ntchris/voron_mod_super_diy/README.md

# voron_mod_super_diy
 all about my voron and ERCF mod
