ntchris/voron_mod_super_diy/Z_joints/notes.txt

cannot reduce height(thick) of Z joint lower, because magnet must point to sensor under xy joint 
unless both reduce 5mm
