ntchris/voron_mod_super_diy/ercf_v2/cnc_80T_pulley_mod/80T_pulley_size.jpg

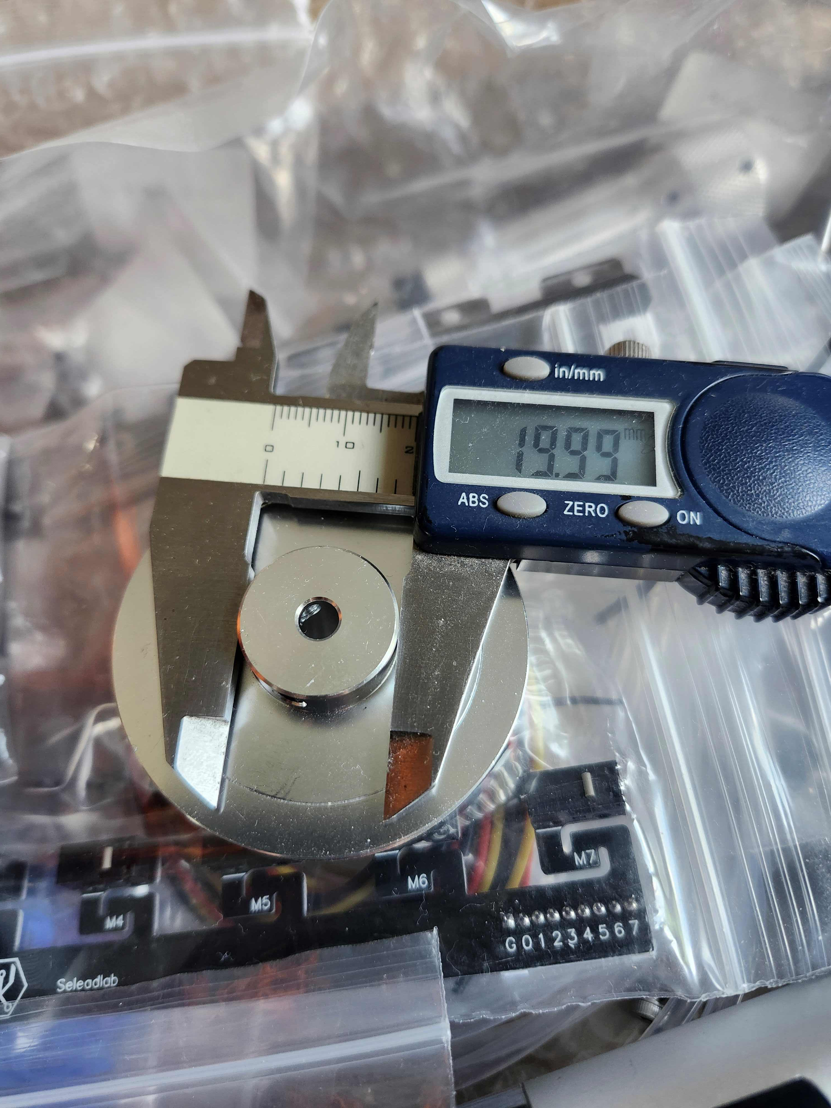
ercf_v2/cnc_80T_pulley_mod/80T_pulley_size.jpg
