ntchris/voron_mod_super_diy/ercf_v2/cnc_80T_pulley_mod/cad_picture1.png

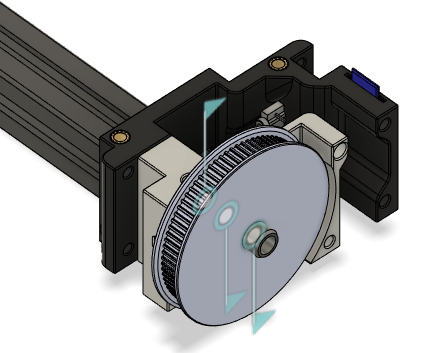
ercf_v2/cnc_80T_pulley_mod/cad_picture1.png
