ntchris/voron_mod_super_diy/ercf_v2/cnc_80T_pulley_mod/cad_picture3.png

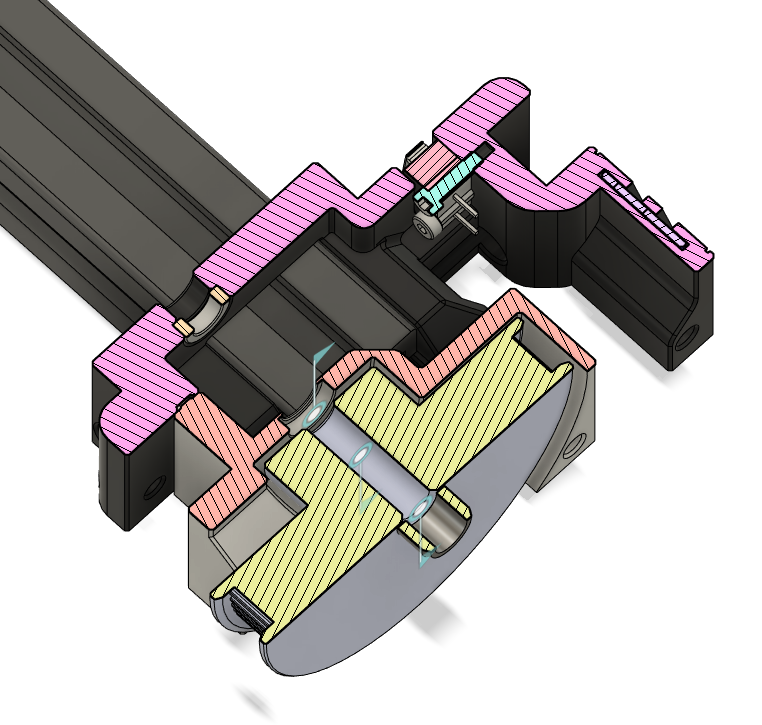
ercf_v2/cnc_80T_pulley_mod/cad_picture3.png
