ntchris/voron_mod_super_diy/ercf_v2/EREC_Cutter_Beta7_Mod/blade.jpg

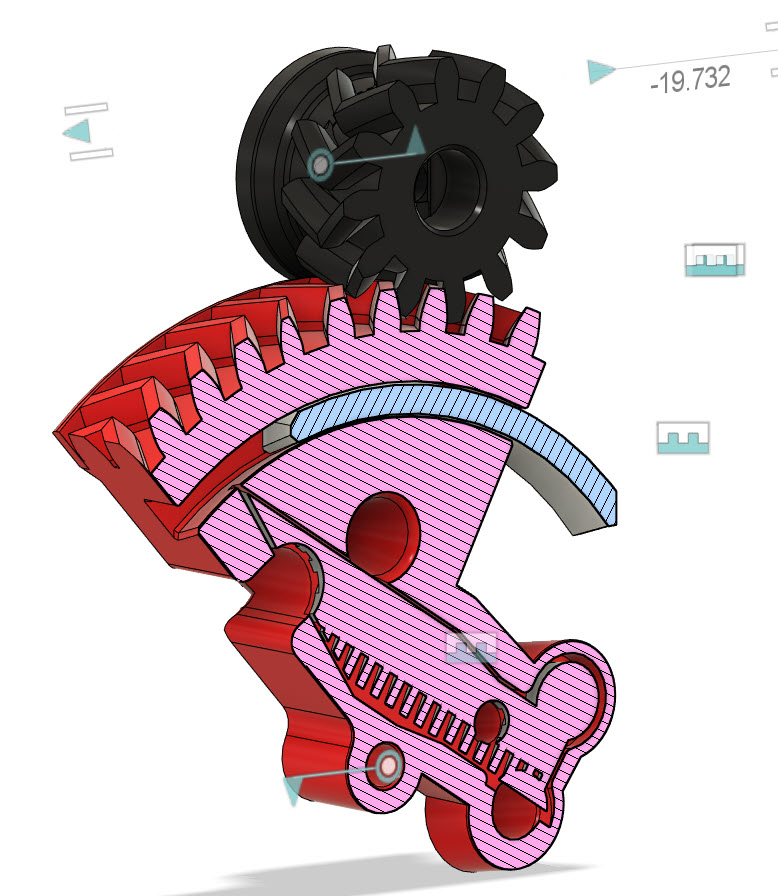
ercf_v2/EREC_Cutter_Beta7_Mod/blade.jpg
