ntchris/voron_mod_super_diy/ercf_v2/EREC_Cutter_Beta7_Mod/with_erec_cutter_beta7_mod.jpg

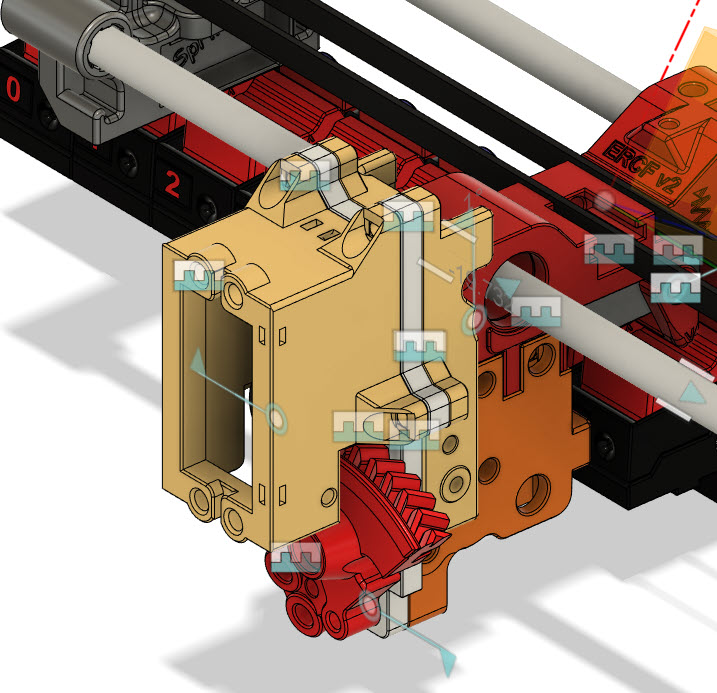
ercf_v2/EREC_Cutter_Beta7_Mod/with_erec_cutter_beta7_mod.jpg
