ntchris/voron_mod_super_diy/ercf_v2/etc/ercf_v2_middle_foot.jpg

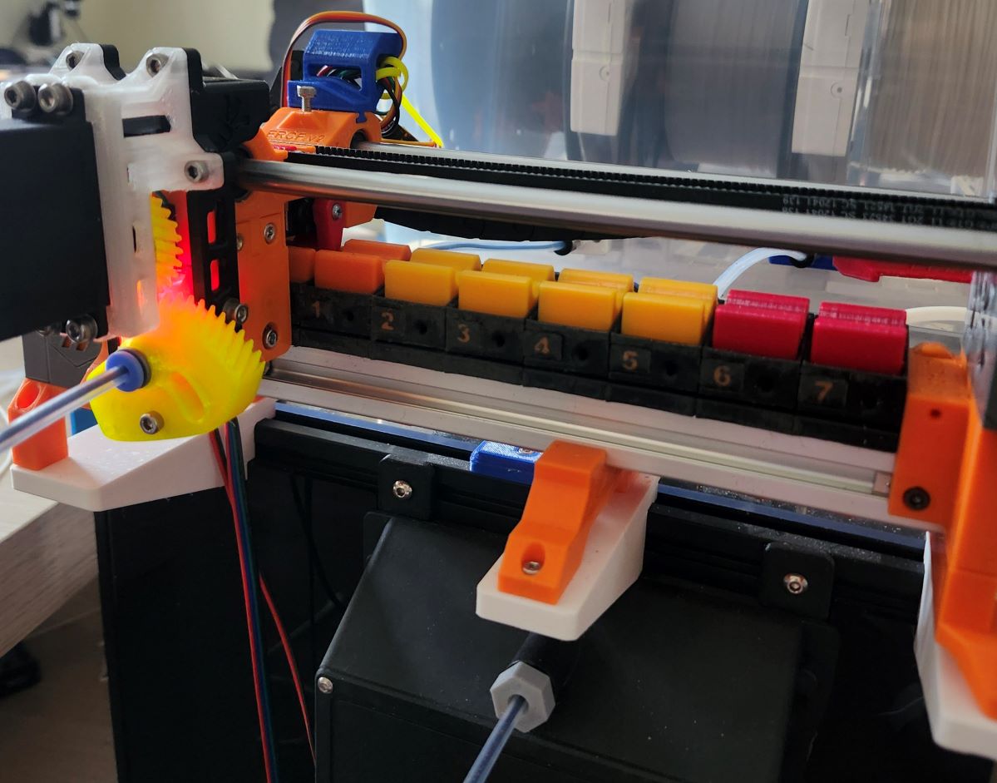
ercf_v2/etc/ercf_v2_middle_foot.jpg
