ntchris/voron_mod_super_diy/ercf_v2/filament_tension_sensor_hall/images/btt_mmb_stp.jpg

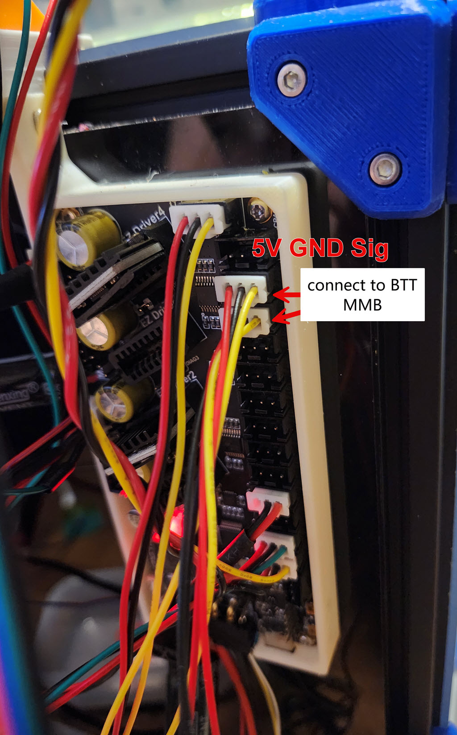
ercf_v2/filament_tension_sensor_hall/images/btt_mmb_stp.jpg
