ntchris/voron_mod_super_diy/ercf_v2/filament_tension_sensor_hall/images/image1.png

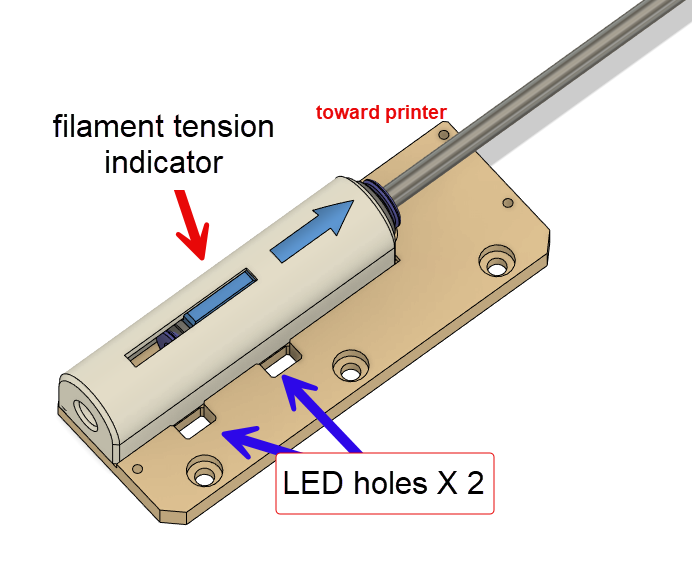
ercf_v2/filament_tension_sensor_hall/images/image1.png
