ntchris/voron_mod_super_diy/ercf_v2/filament_tension_sensor_hall/images/schematics.jpg

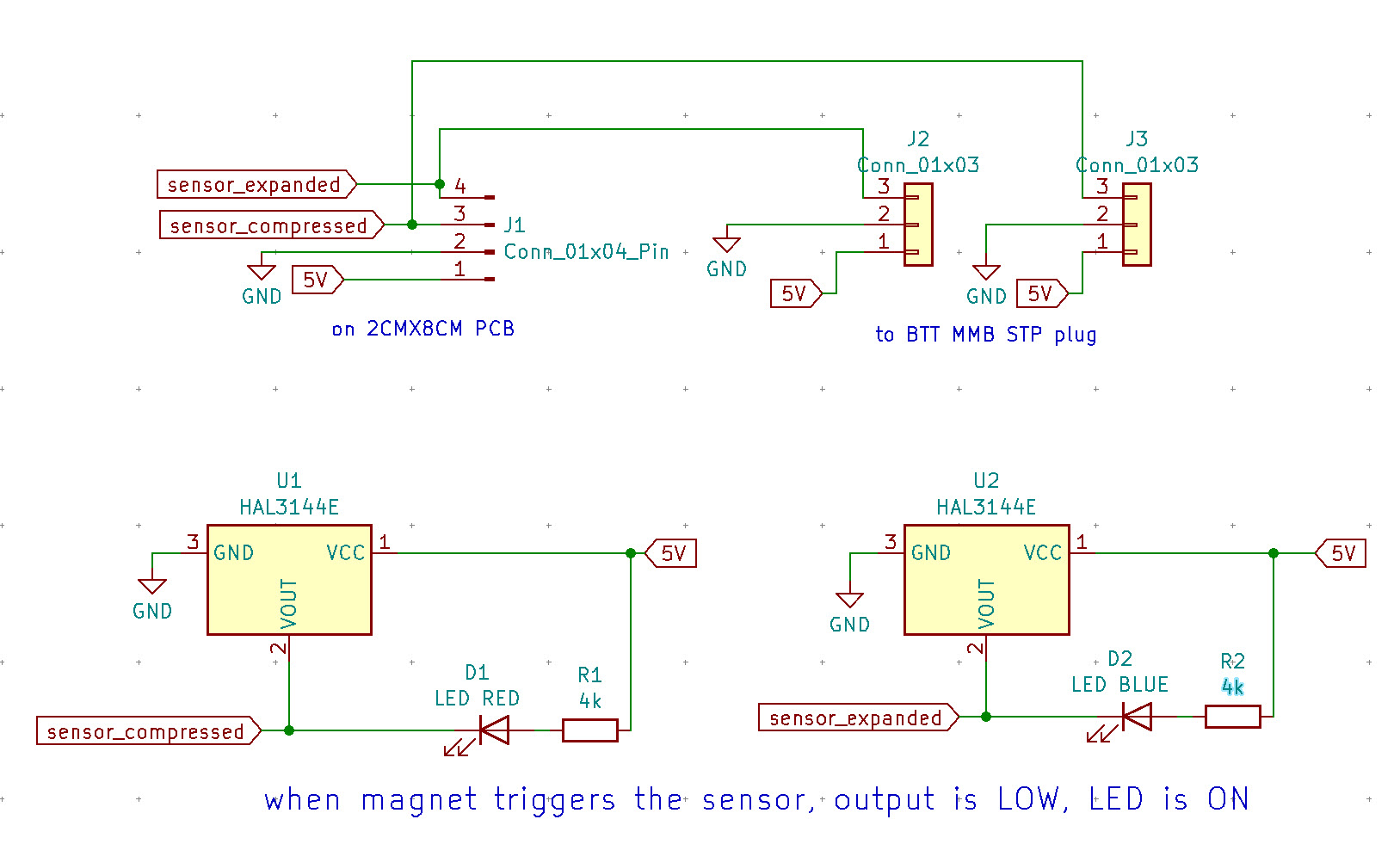
ercf_v2/filament_tension_sensor_hall/images/schematics.jpg
