ntchris/voron_mod_super_diy/ercf_v2/servo_28mm_selector_ver2/pictures/encoder_right_half.jpg

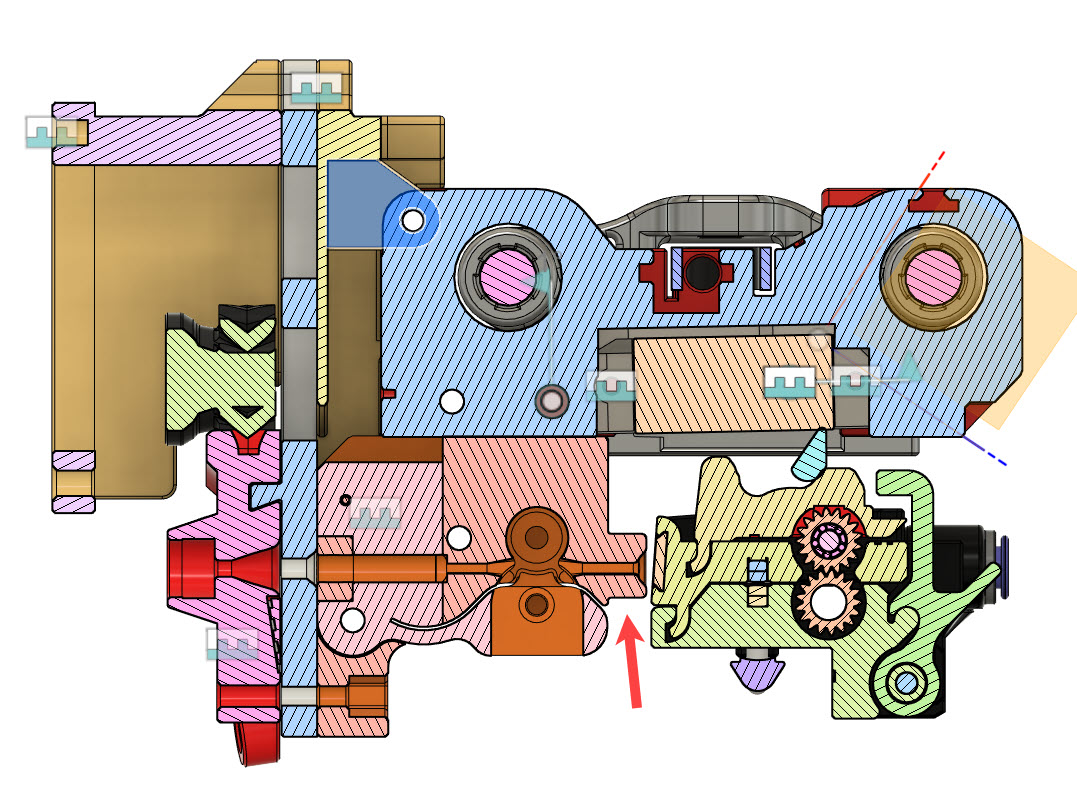
ercf_v2/servo_28mm_selector_ver2/pictures/encoder_right_half.jpg
