ntchris/voron_mod_super_diy/ercf_v2/servo_28mm_selector_ver2/pictures/servo28mm.jpg

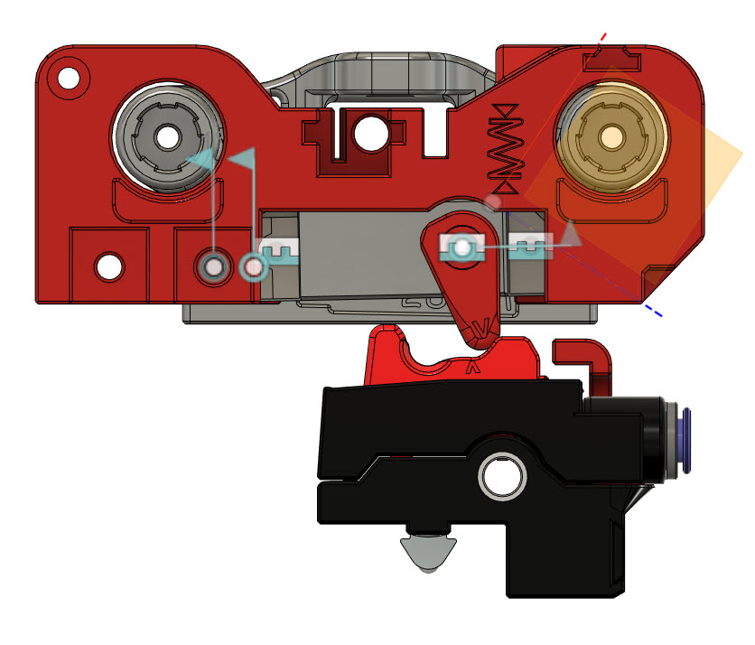
ercf_v2/servo_28mm_selector_ver2/pictures/servo28mm.jpg
