ntchris/voron_mod_super_diy/for_enraged_rabbit/about_servo/Guo_Hua_9g_A0090.jpg

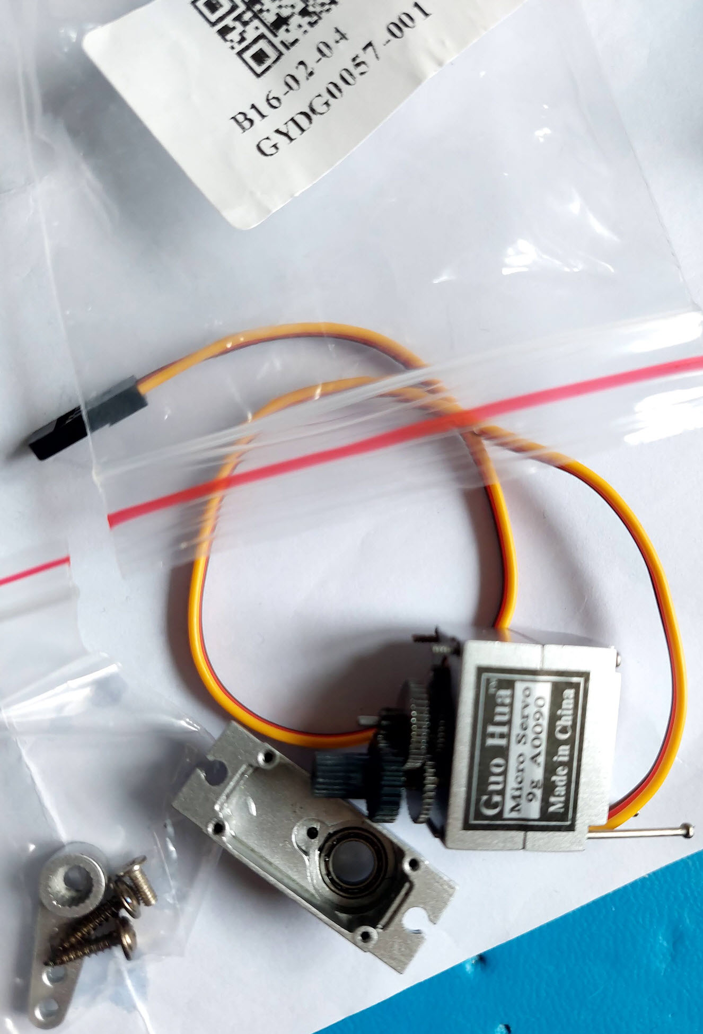
for_enraged_rabbit/about_servo/Guo_Hua_9g_A0090.jpg
