ntchris/voron_mod_super_diy/for_enraged_rabbit/about_servo/surpass_17g.jpg

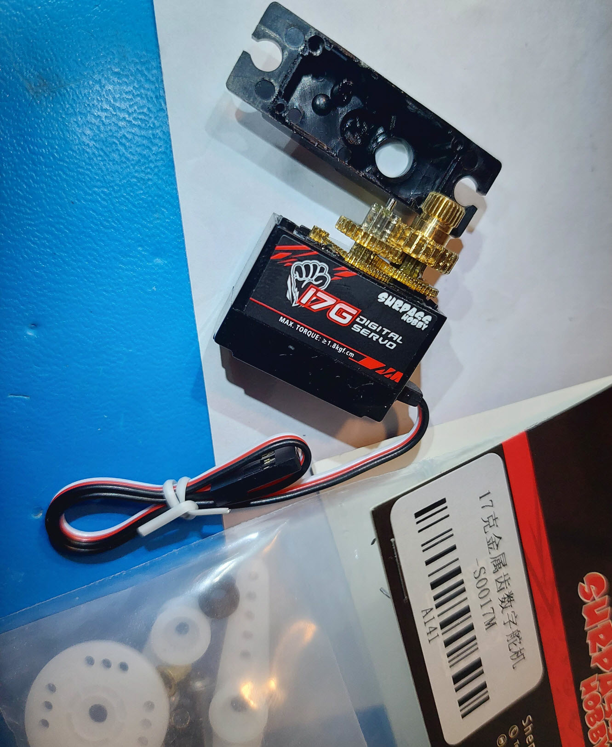
for_enraged_rabbit/about_servo/surpass_17g.jpg
