ntchris/voron_mod_super_diy/for_enraged_rabbit/mellow_ERCF_CanBus/mellow_ercf_jumper.jpg

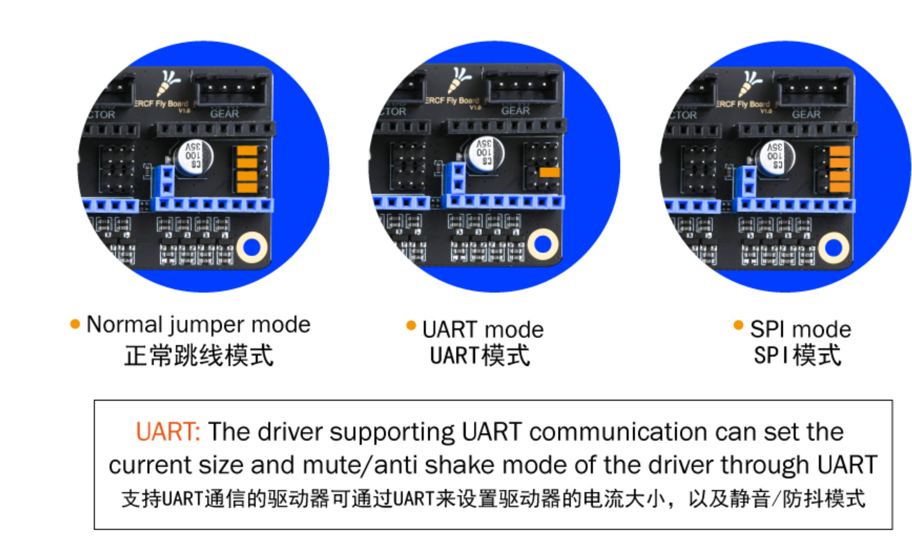
for_enraged_rabbit/mellow_ERCF_CanBus/mellow_ercf_jumper.jpg
