ntchris/voron_mod_super_diy/for_enraged_rabbit/mount_on_voron/ercf_mount2.jpg

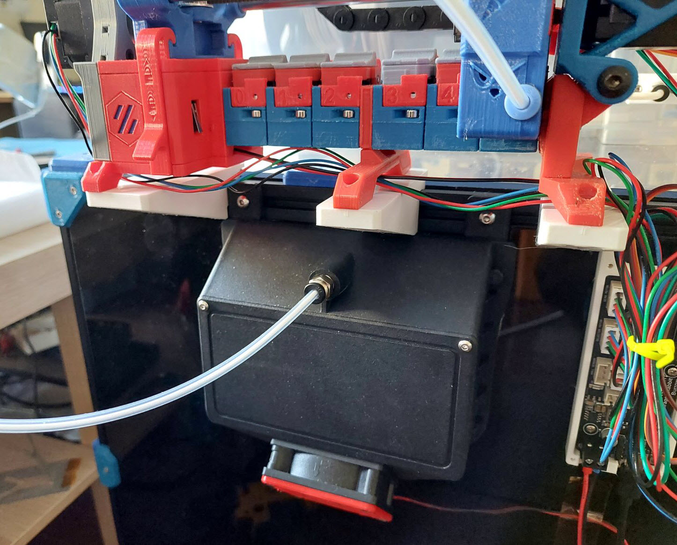
for_enraged_rabbit/mount_on_voron/ercf_mount2.jpg
