ntchris/voron_mod_super_diy/for_enraged_rabbit/optical_endstop_selector/optical_endstop_inside.jpg

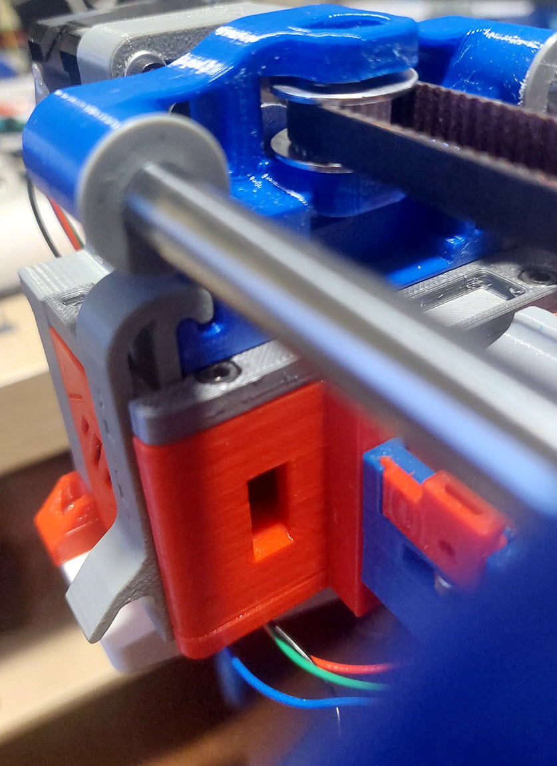
for_enraged_rabbit/optical_endstop_selector/optical_endstop_inside.jpg
