ntchris/voron_mod_super_diy/for_enraged_rabbit/optical_endstop_selector_button/show1.jpg

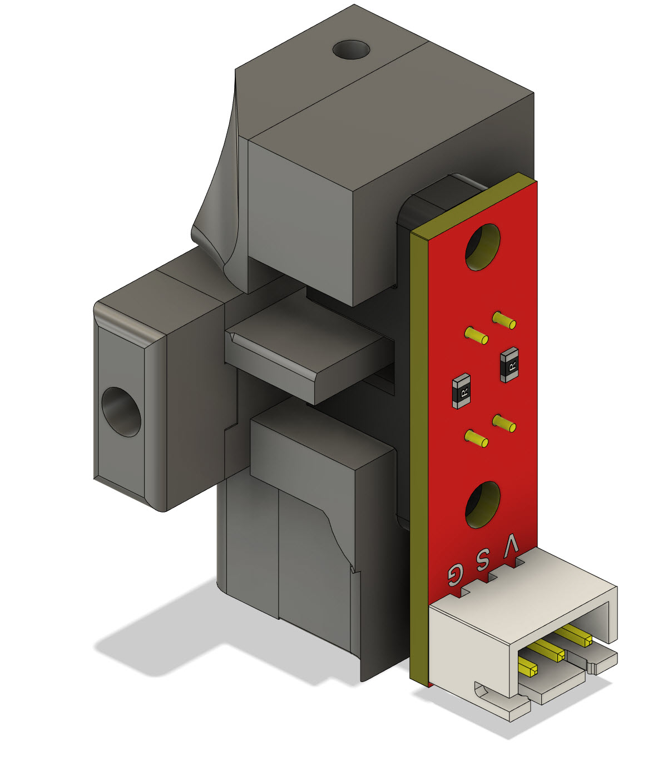
for_enraged_rabbit/optical_endstop_selector_button/show1.jpg
