ntchris/voron_mod_super_diy/for_enraged_rabbit/optical_endstop_selector_button/show2.jpg

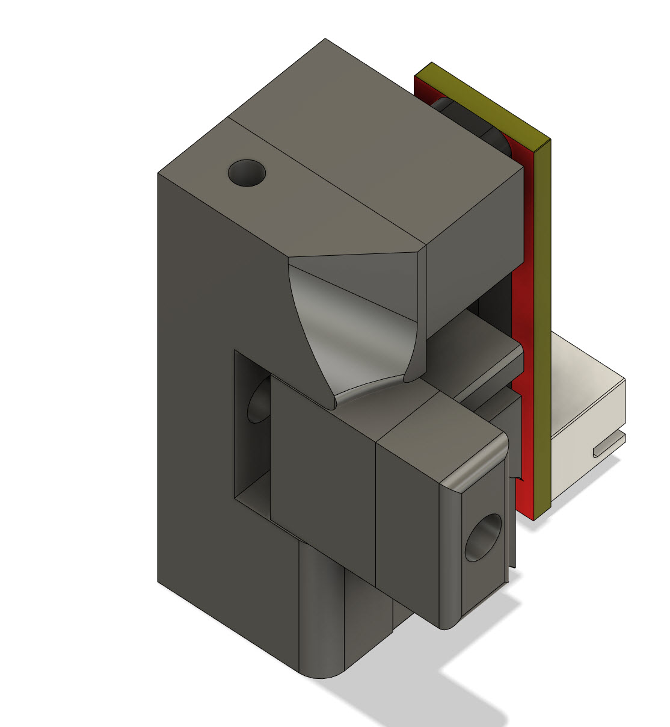
for_enraged_rabbit/optical_endstop_selector_button/show2.jpg
