ntchris/voron_mod_super_diy/stealth_burner_rail_mount/voron_stealburn_x_belt_show.jpg

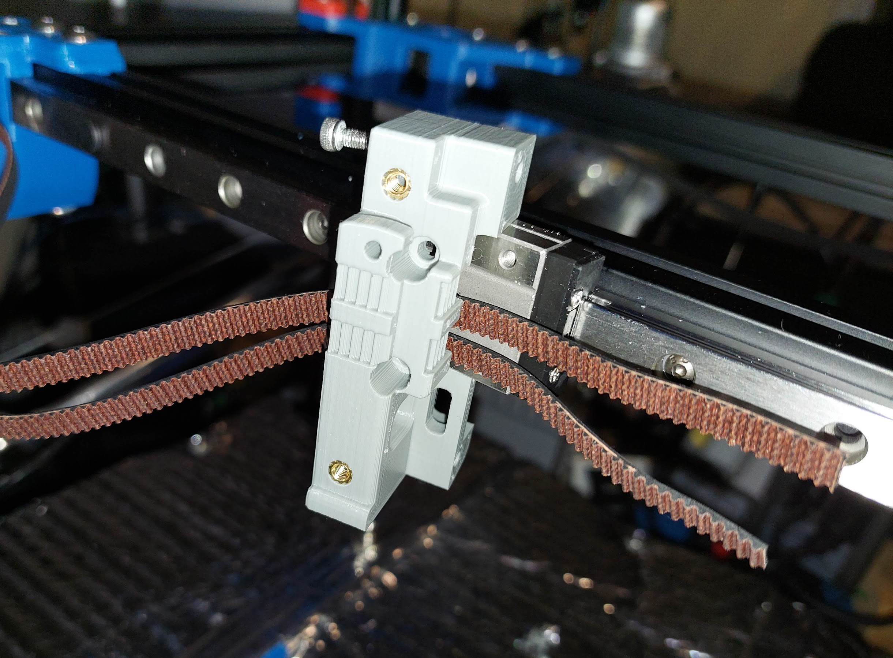
stealth_burner_rail_mount/voron_stealburn_x_belt_show.jpg
