ntchris/voron_mod_super_diy/super_diy_motor_buffer_mmu_samla/doc/magnet_1.jpg

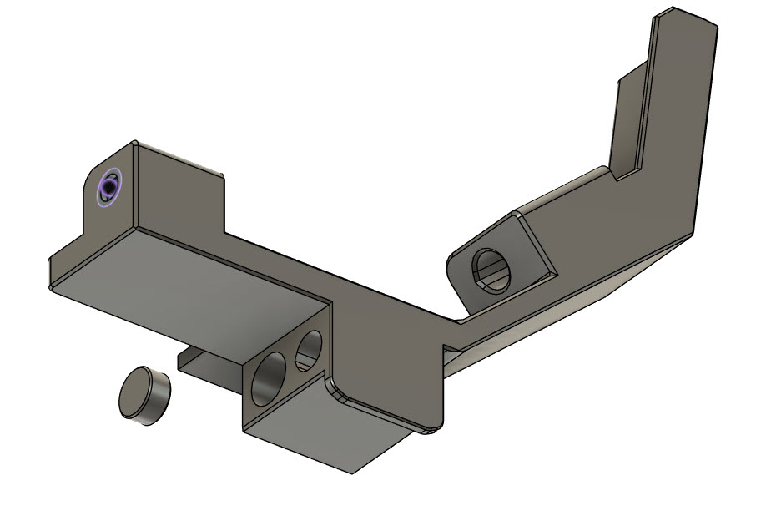
super_diy_motor_buffer_mmu_samla/doc/magnet_1.jpg
