ntchris/voron_mod_super_diy/super_diy_motor_buffer_mmu_samla/doc/main_base_heat_insert.jpg

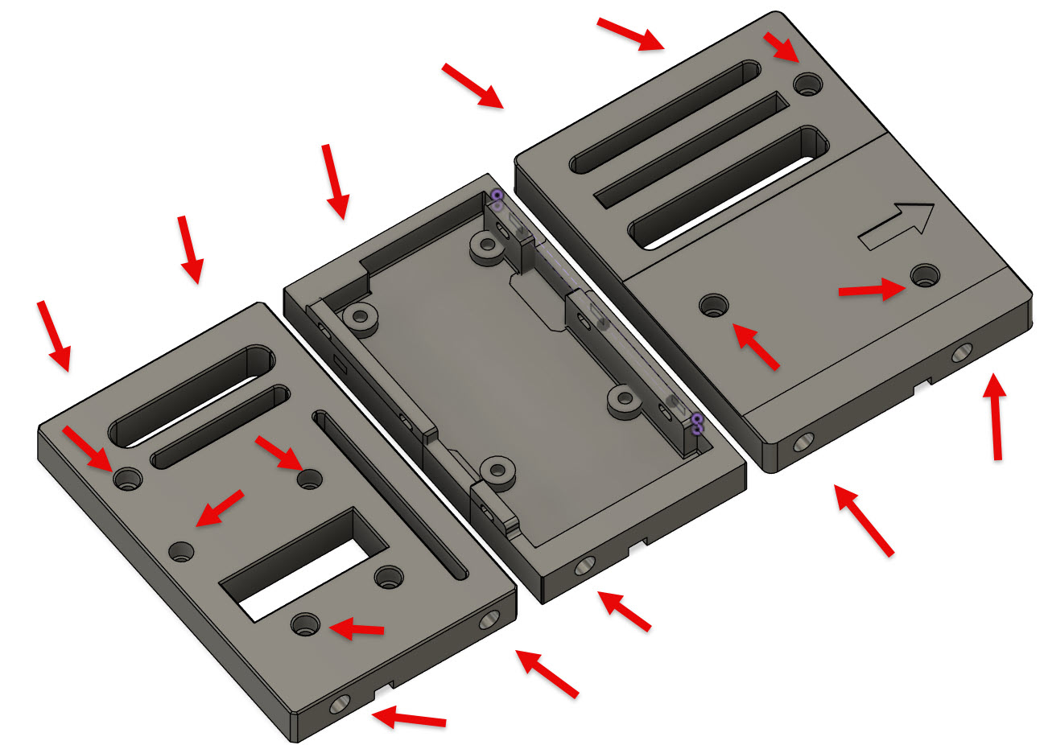
super_diy_motor_buffer_mmu_samla/doc/main_base_heat_insert.jpg
