ntchris/voron_mod_super_diy/super_diy_motor_buffer_mmu_samla/doc/push_pull_sensor.jpg

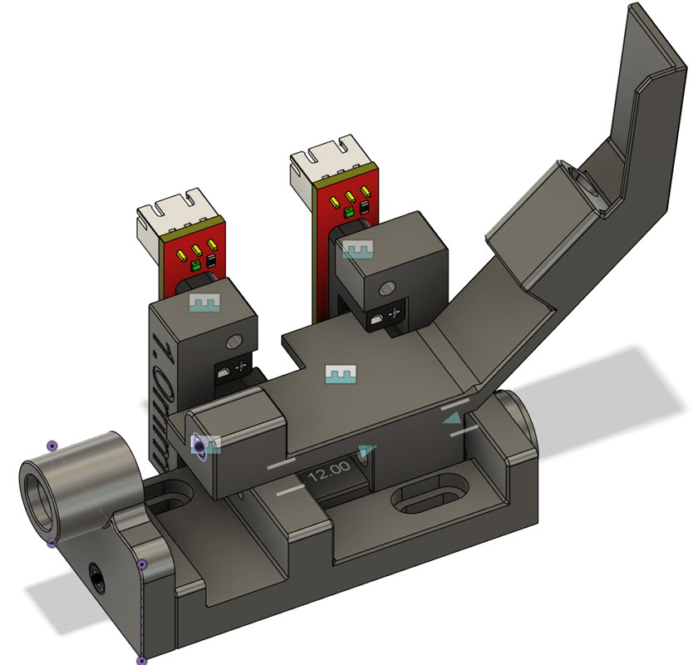
super_diy_motor_buffer_mmu_samla/doc/push_pull_sensor.jpg
