ntchris/voron_mod_super_diy/super_diy_motor_buffer_mmu_samla/doc/sensor_module_on_base.jpg

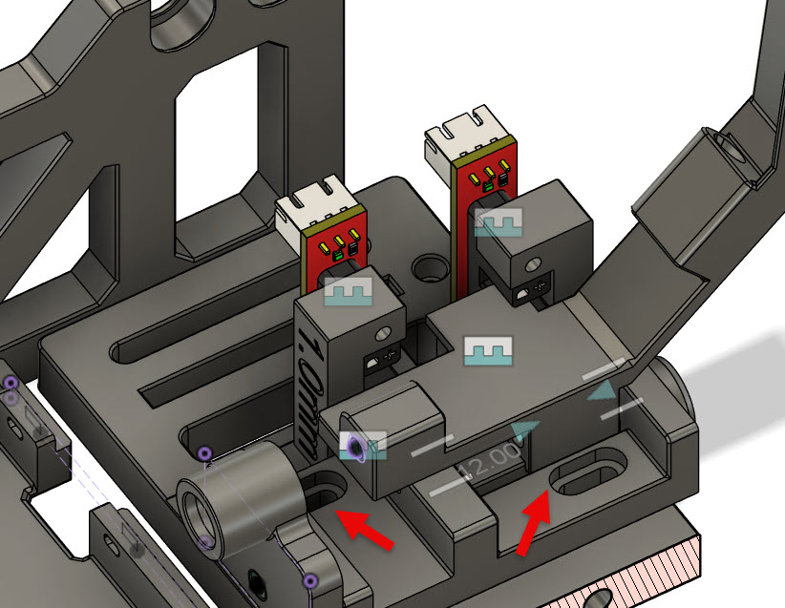
super_diy_motor_buffer_mmu_samla/doc/sensor_module_on_base.jpg
