ntchris/voron_mod_super_diy/super_diy_motor_buffer_mmu_samla/software/Pinout-Arduino-Nano-low-resolution.jpg

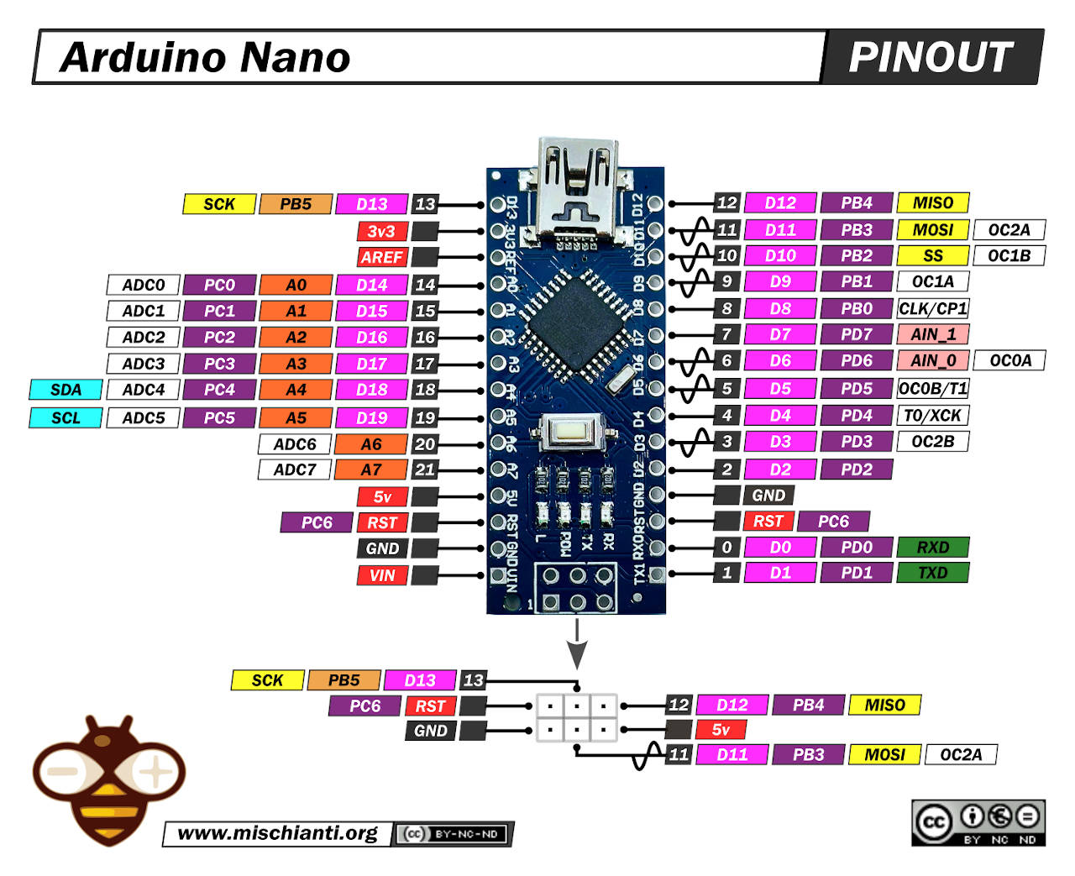
super_diy_motor_buffer_mmu_samla/software/Pinout-Arduino-Nano-low-resolution.jpg
