ntchris/voron_mod_super_diy/XY_Joints/M5_xy_joint_weight.jpg

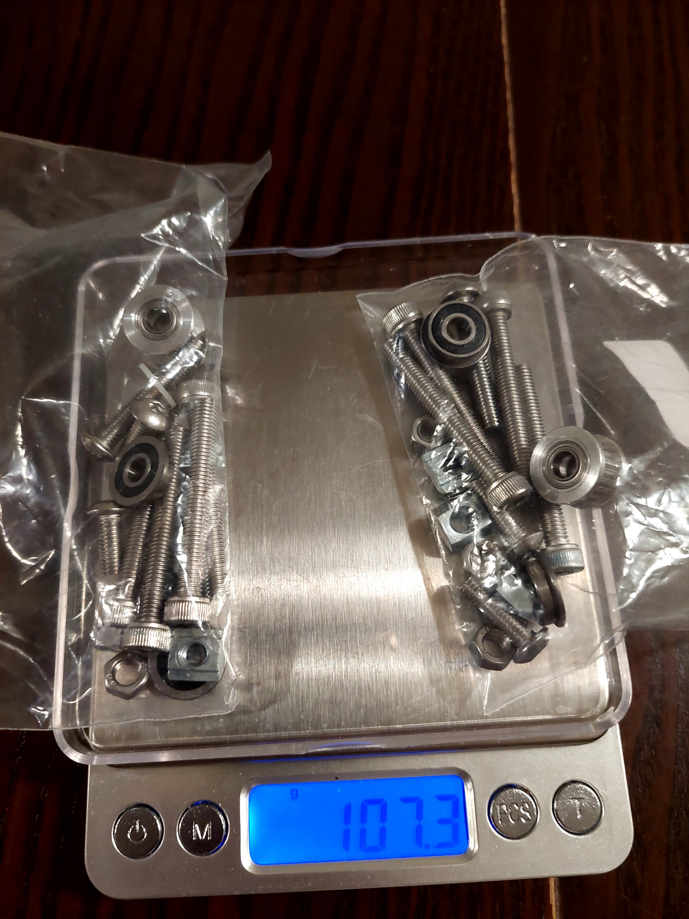
XY_Joints/M5_xy_joint_weight.jpg
