ntchris/voron_mod_super_diy/Z_Idlers_mods/z_idler_bracket_M4.jpg

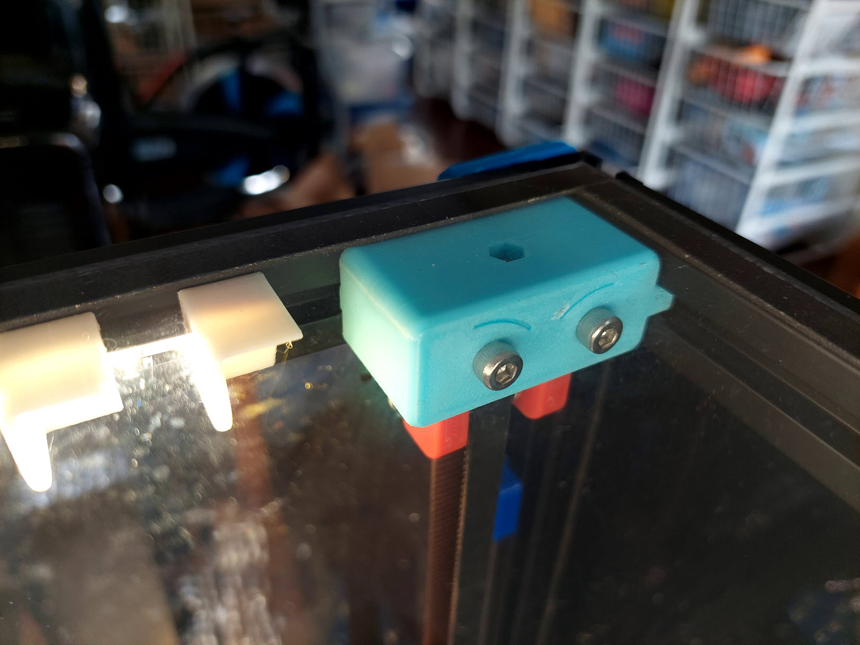
Z_Idlers_mods/z_idler_bracket_M4.jpg
