ntchris/voron_mod_super_diy/ercf_v2/EREC_Cutter_Beta7_Mod/CAD/ercf_cutter_beta7_adaptor.step

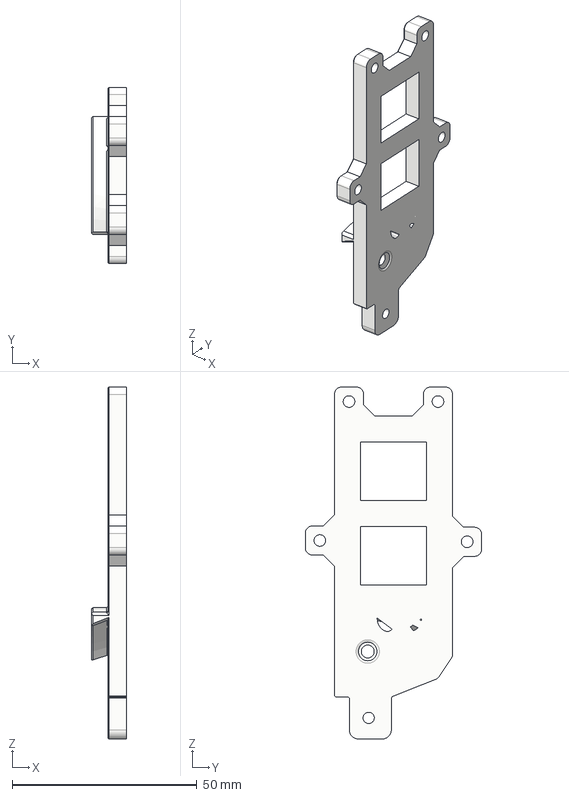
[picture p76: CAD file, 2024-09-14]
ercf_v2/EREC_Cutter_Beta7_Mod/CAD/ercf_cutter_beta7_adaptor.step
9.35 x 47.8 x 95.3 mm
