ntchris/voron_mod_super_diy/ercf_v2/etc/drag_chain_body.stl

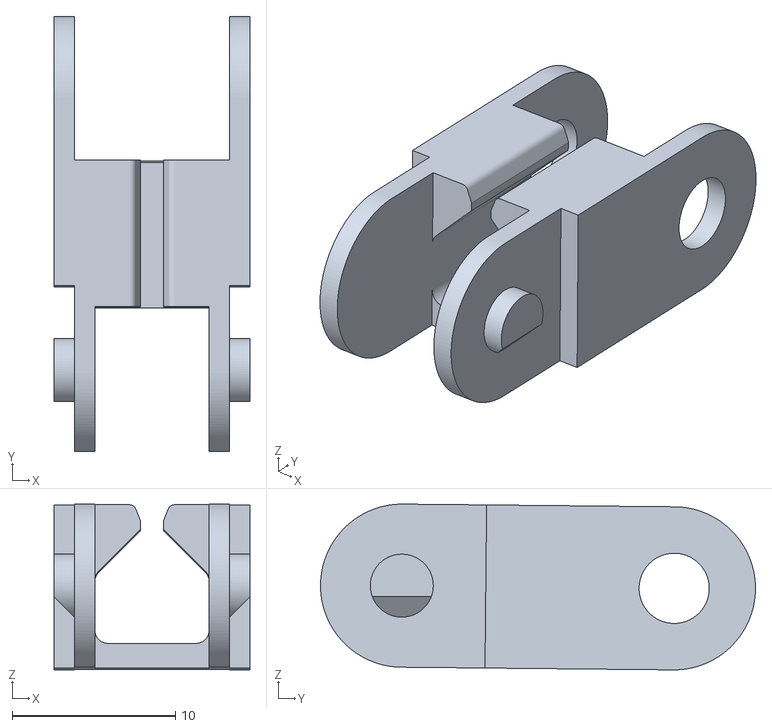
[picture p77: CAD file, 2024-08-27]
ercf_v2/etc/drag_chain_body.stl
12.0 x 26.7 x 10.2
