ntchris/voron_mod_super_diy/ercf_v2/filament_tension_sensor_hall/CAD/mover.step

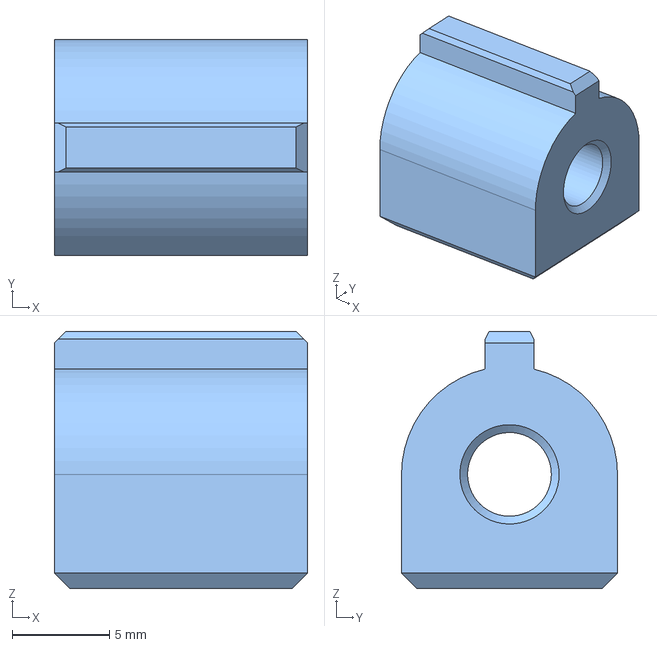
[picture p78: CAD file, 2024-08-27]
ercf_v2/filament_tension_sensor_hall/CAD/mover.step
13.0 x 11.1 x 13.2 mm
