ntchris/voron_mod_super_diy/ercf_v2/filament_tension_sensor_hall/stl/sign.stl

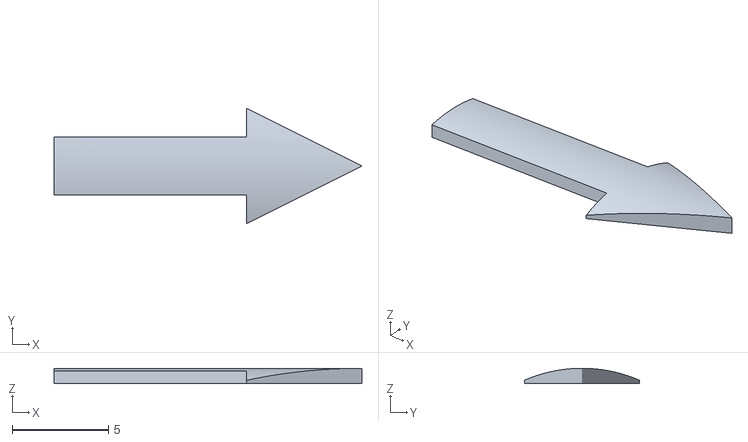
[picture p79: CAD file, 2024-08-27]
ercf_v2/filament_tension_sensor_hall/stl/sign.stl
16.0 x 6.00 x 0.8
