ntchris/voron_mod_super_diy/ercf_v2/power_drive_selector_60T_pulley/CAD/pulley_mount_default_M5.step

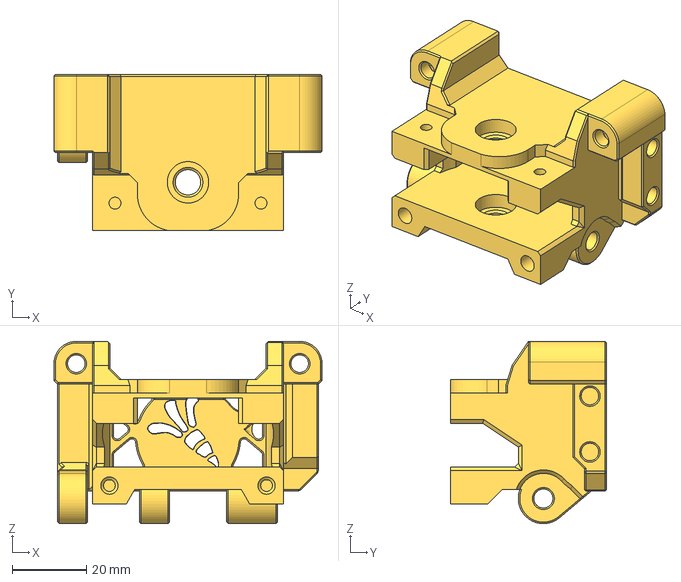
[picture p80: CAD file, 2024-09-14]
ercf_v2/power_drive_selector_60T_pulley/CAD/pulley_mount_default_M5.step
72.0 x 42.0 x 48.9 mm
