ntchris/voron_mod_super_diy/ercf_v2/servo_28mm_selector_ver2/CAD/servo_arm_6mm_25T.step

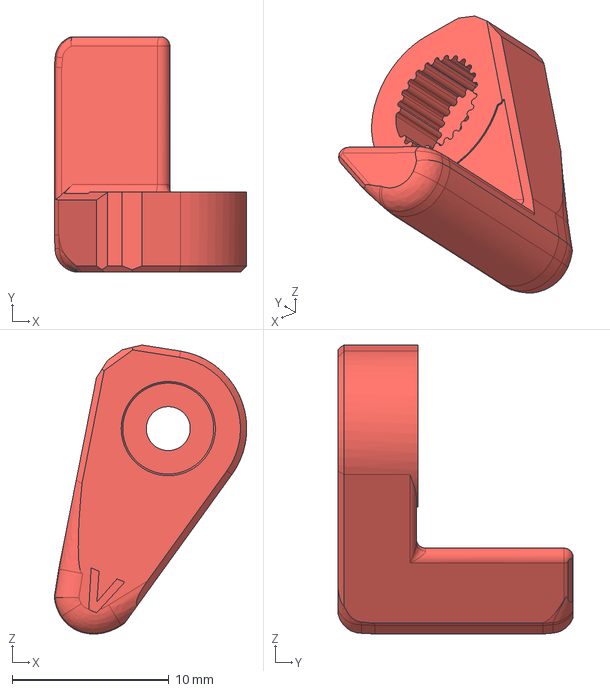
[picture p81: CAD file, 2024-09-14]
ercf_v2/servo_28mm_selector_ver2/CAD/servo_arm_6mm_25T.step
12.3 x 15.0 x 18.4 mm
