ntchris/voron_mod_super_diy/Exhaust_Filter/[a]_exhaust_filter_mount_M3_x2.step

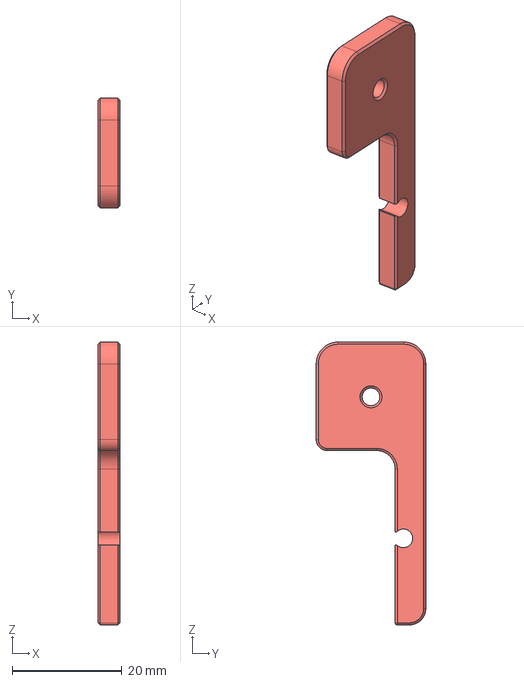
[picture p82: CAD file, 2023-09-17]
Exhaust_Filter/[a]_exhaust_filter_mount_M3_x2.step
4.00 x 20.0 x 51.6 mm
