ntchris/voron_mod_super_diy/for_enraged_rabbit/easy_optical/cad_stl/easy_optical_pcb.step

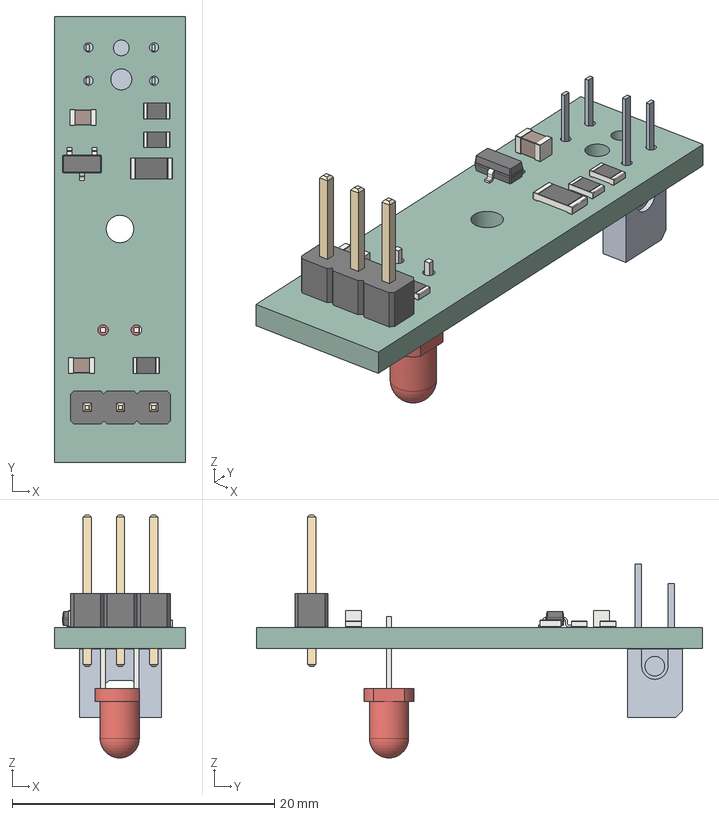
[picture p83: CAD file, 2023-10-31]
for_enraged_rabbit/easy_optical/cad_stl/easy_optical_pcb.step
10.0 x 34.0 x 18.5 mm
_autosave-easy_optical_pcb PCB
