ntchris/voron_mod_super_diy/for_enraged_rabbit/mount_on_voron/ercf_pcb_mount_side_mellow_canbus.stl

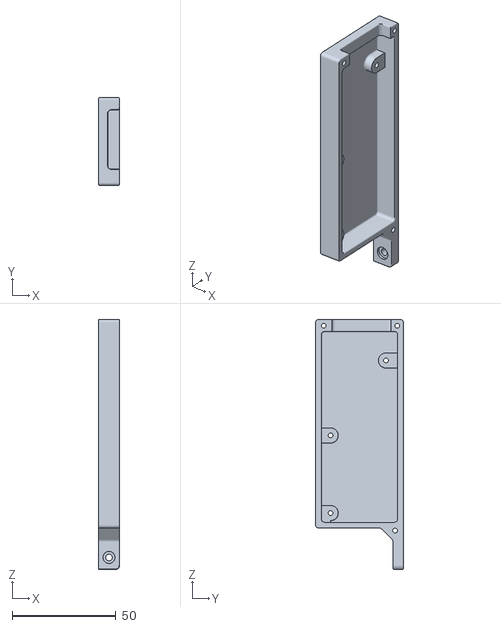
[picture p84: CAD file, 2023-10-22]
for_enraged_rabbit/mount_on_voron/ercf_pcb_mount_side_mellow_canbus.stl
10.2 x 42.4 x 120.6
