ntchris/voron_mod_super_diy/for_enraged_rabbit/optical_endstop_selector/ercf_top_panel_optical.stl

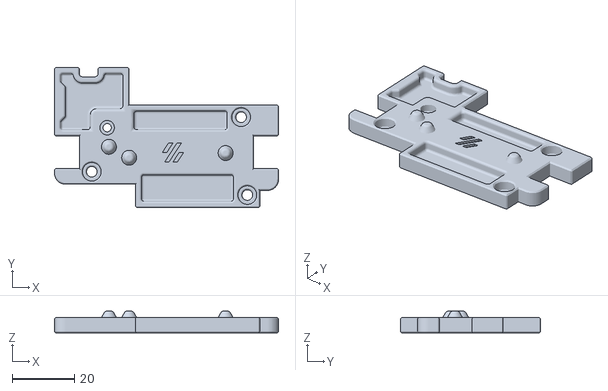
[picture p85: CAD file, 2023-10-22]
for_enraged_rabbit/optical_endstop_selector/ercf_top_panel_optical.stl
72.0 x 45.0 x 7.00
