ntchris/voron_mod_super_diy/for_enraged_rabbit/optical_endstop_selector_button/pin_button_front.stl

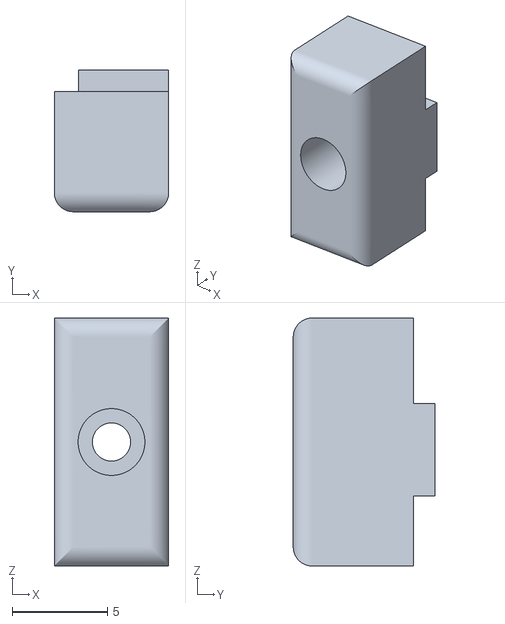
[picture p86: CAD file, 2023-10-22]
for_enraged_rabbit/optical_endstop_selector_button/pin_button_front.stl
6.00 x 7.42 x 13.0
