ntchris/voron_mod_super_diy/stealth_burner_rail_mount/x_carriage_frame_left_belt_wrap.step

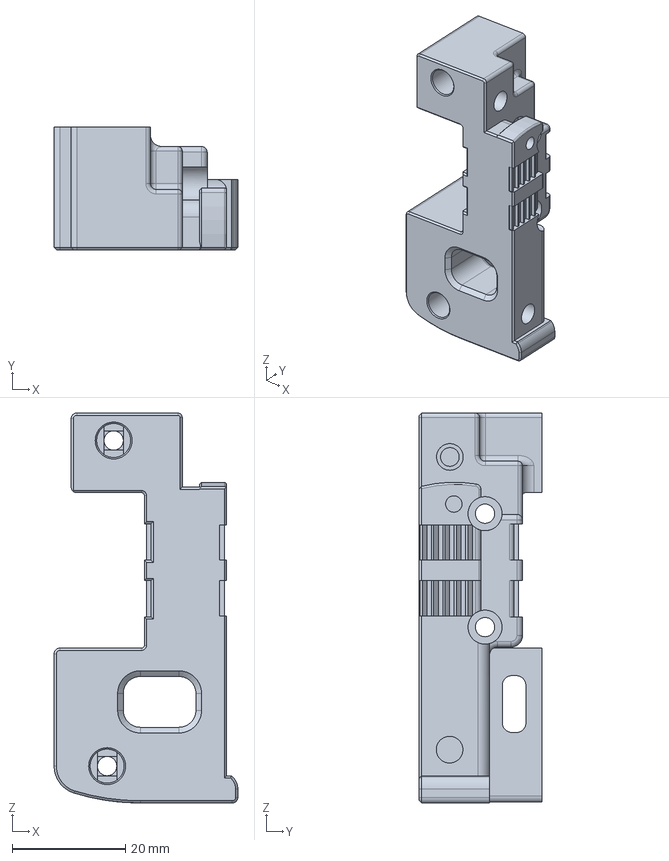
[picture p87: CAD file, 2023-09-17]
stealth_burner_rail_mount/x_carriage_frame_left_belt_wrap.step
32.4 x 21.6 x 68.8 mm
