ntchris/voron_mod_super_diy/XY_Joints/xy_joint_left_upper_M4.step

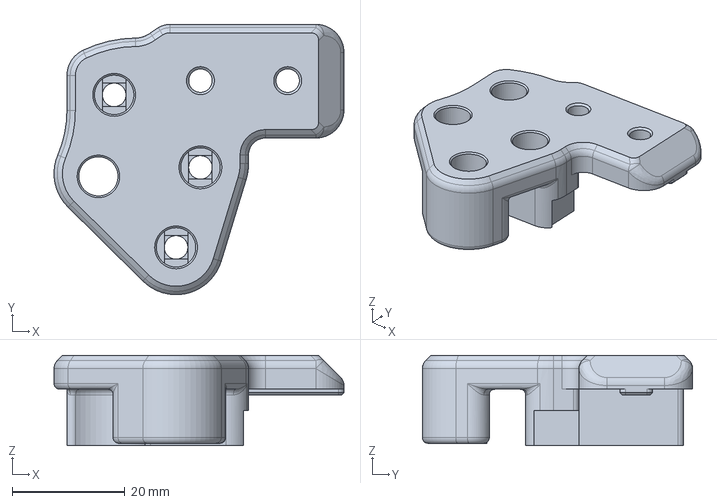
[picture p88: CAD file, 2023-09-17]
XY_Joints/xy_joint_left_upper_M4.step
51.5 x 48.0 x 16.0 mm
