ntchris/voron_mod_super_diy/Z_Idlers_mods/z_tensioner_bracket_M4_b_x2.step

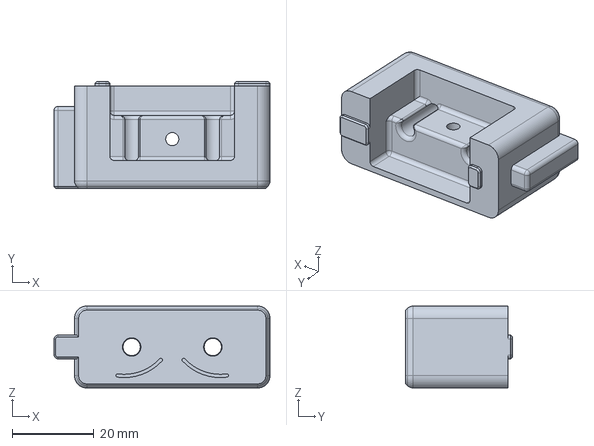
[picture p89: CAD file, 2023-09-17]
Z_Idlers_mods/z_tensioner_bracket_M4_b_x2.step
52.7 x 26.0 x 20.0 mm
