ntchris/voron_mod_super_diy/ercf_v2/EREC_Cutter_Beta7_Mod/CAD/Cutter_Arm_ECAS_Open.step

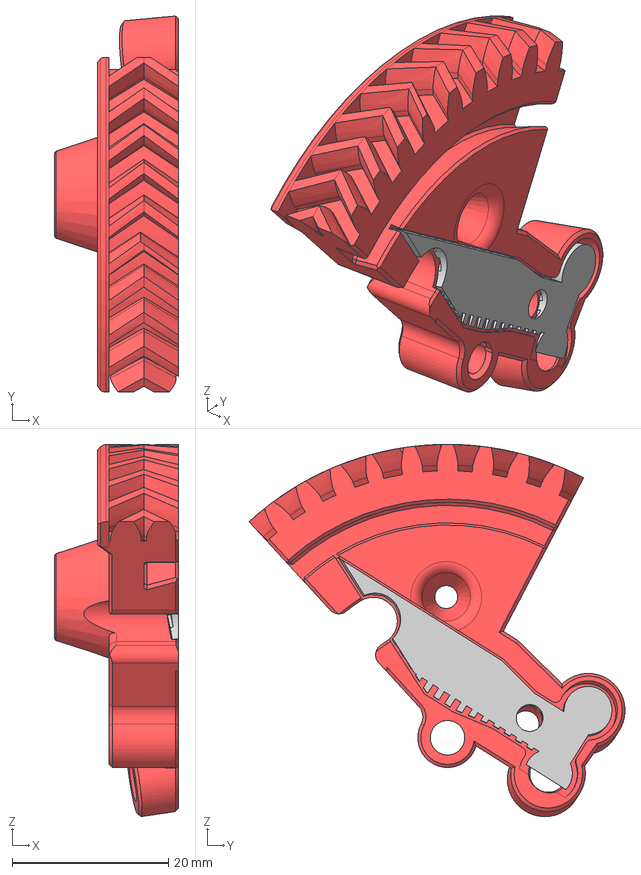
[picture p90: CAD file, 2024-09-14]
ercf_v2/EREC_Cutter_Beta7_Mod/CAD/Cutter_Arm_ECAS_Open.step
15.9 x 48.1 x 47.6 mm
