ntchris/voron_mod_super_diy/ercf_v2/etc/erec_encoder_mount_for_thicker_selector_28mm.stl

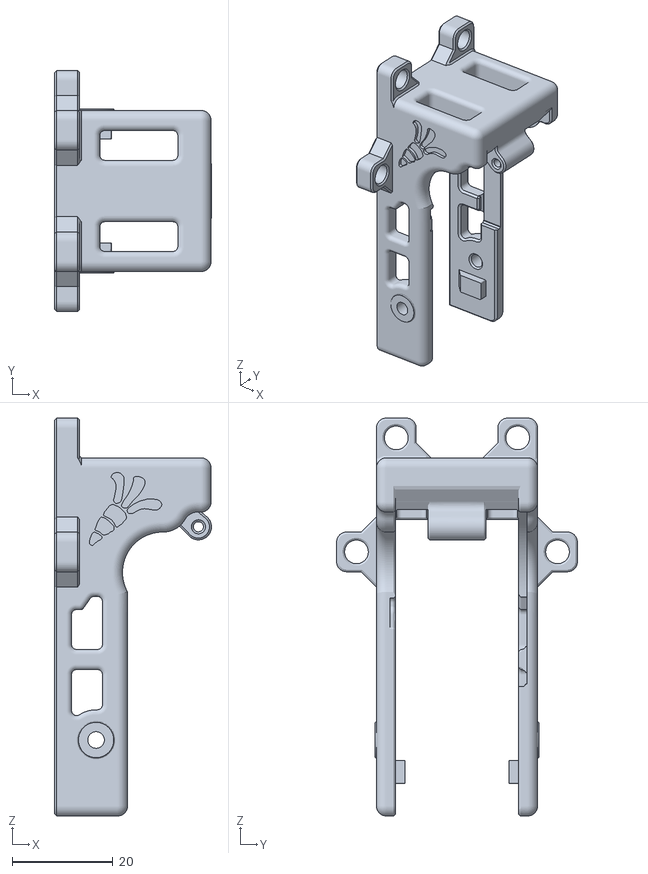
[picture p91: CAD file, 2024-08-11]
ercf_v2/etc/erec_encoder_mount_for_thicker_selector_28mm.stl
31.2 x 47.8 x 79.0
