ntchris/voron_mod_super_diy/ercf_v2/filament_tension_sensor_hall/CAD/case.step

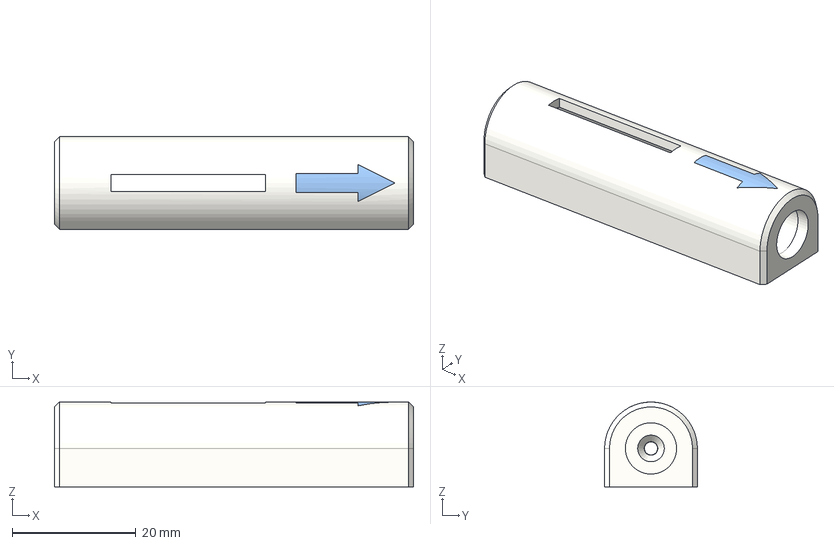
[picture p92: CAD file, 2024-08-27]
ercf_v2/filament_tension_sensor_hall/CAD/case.step
58.0 x 15.0 x 13.7 mm
