ntchris/voron_mod_super_diy/ercf_v2/servo_28mm_selector_ver2/CAD/EREC_Cutter_Encoder_Right_servo_28mm_Vbearing.step

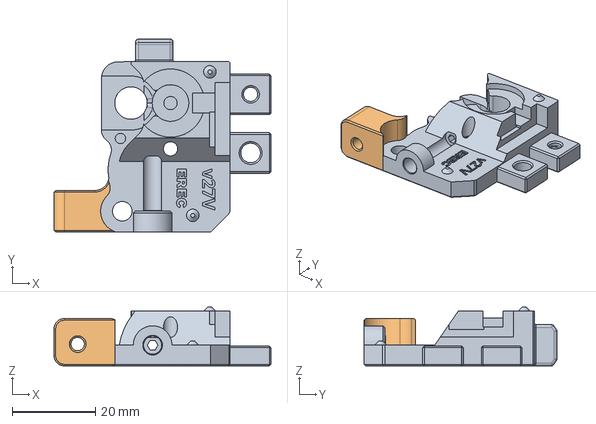
[picture p93: CAD file, 2024-09-14]
ercf_v2/servo_28mm_selector_ver2/CAD/EREC_Cutter_Encoder_Right_servo_28mm_Vbearing.step
52.1 x 46.4 x 14.2 mm
