ntchris/voron_mod_super_diy/for_enraged_rabbit/easy_optical/cad_stl/Encoder_Slotted_Wheel.step

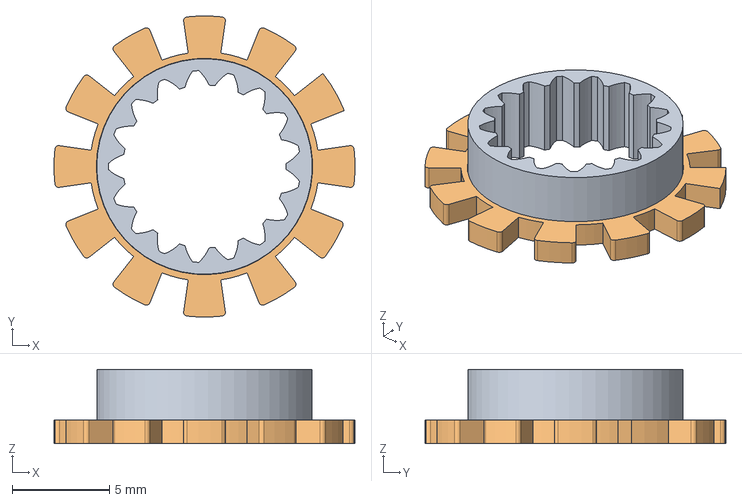
[picture p94: CAD file, 2023-10-31]
for_enraged_rabbit/easy_optical/cad_stl/Encoder_Slotted_Wheel.step
15.4 x 15.4 x 3.80 mm
