ntchris/voron_mod_super_diy/for_enraged_rabbit/optical_endstop_selector/light_blocker_M3.stl

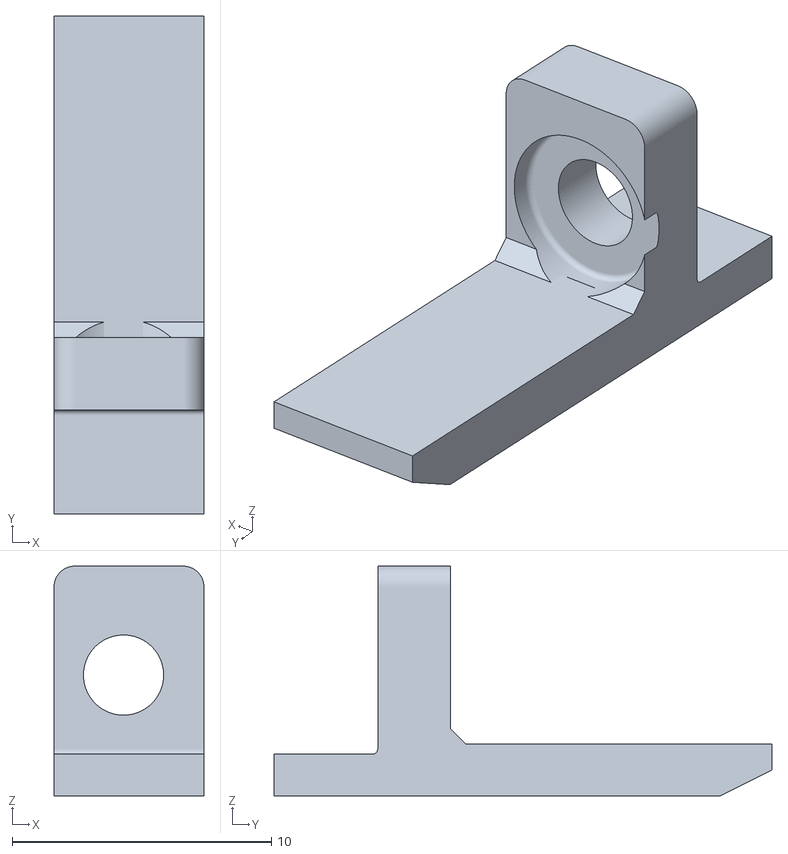
[picture p96: CAD file, 2023-10-22]
for_enraged_rabbit/optical_endstop_selector/light_blocker_M3.stl
5.78 x 19.2 x 8.86
