ntchris/voron_mod_super_diy/XY_Joints/xy_joint_left_lower_M4.step

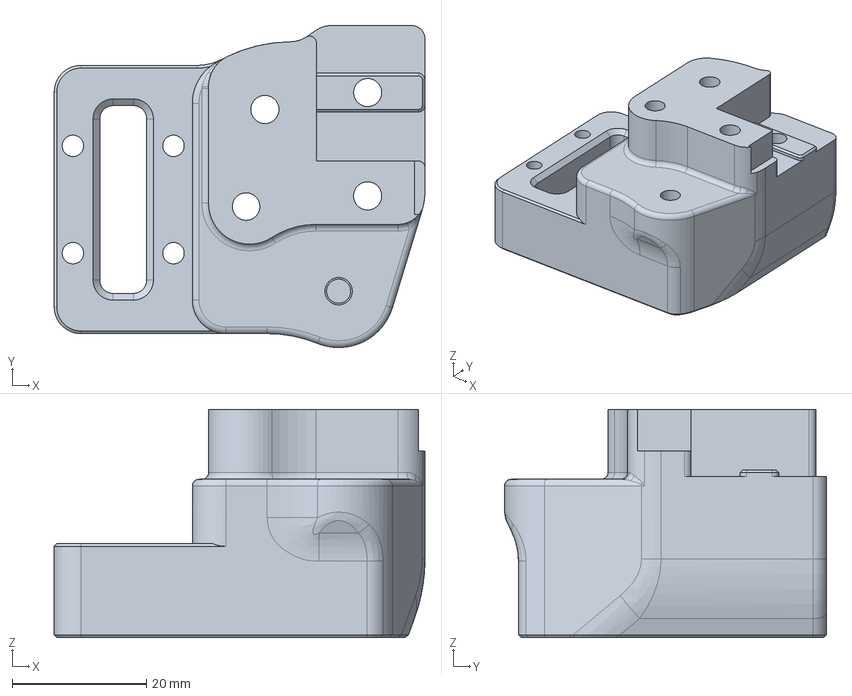
[picture p98: CAD file, 2023-09-17]
XY_Joints/xy_joint_left_lower_M4.step
55.3 x 48.0 x 34.0 mm
