ntchris/voron_mod_super_diy/Z_Idlers_mods/[a]_z_tensioner_x4_M4.stl

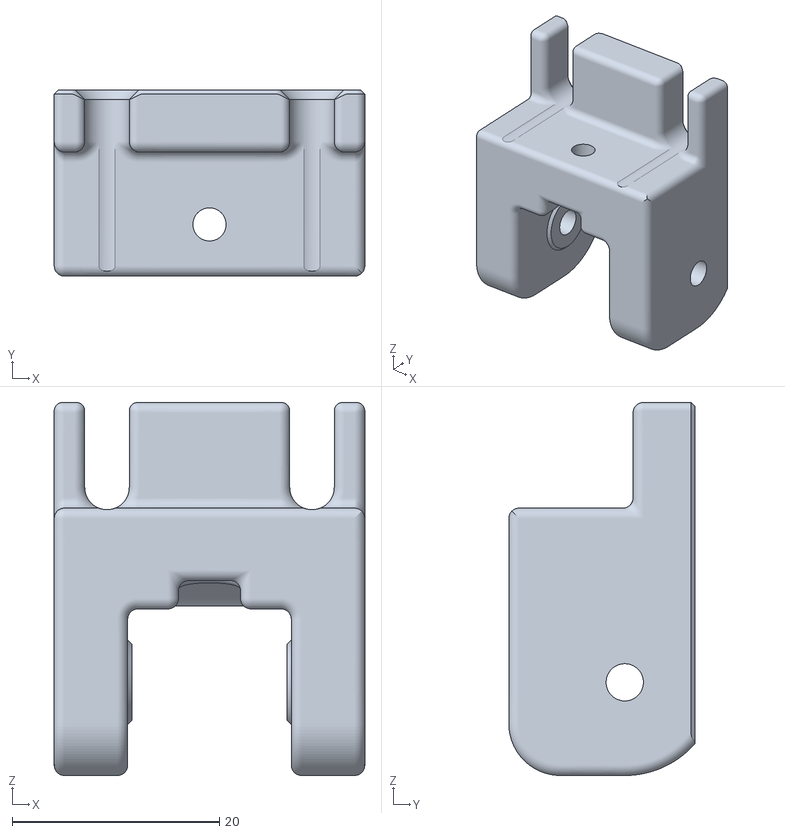
[picture p99: CAD file, 2023-09-17]
Z_Idlers_mods/[a]_z_tensioner_x4_M4.stl
30.0 x 18.0 x 36.0
