ntchris/voron_mod_super_diy/ercf_v2/cnc_80T_pulley_mod/Gear_Box_Back_CNC_80T.step

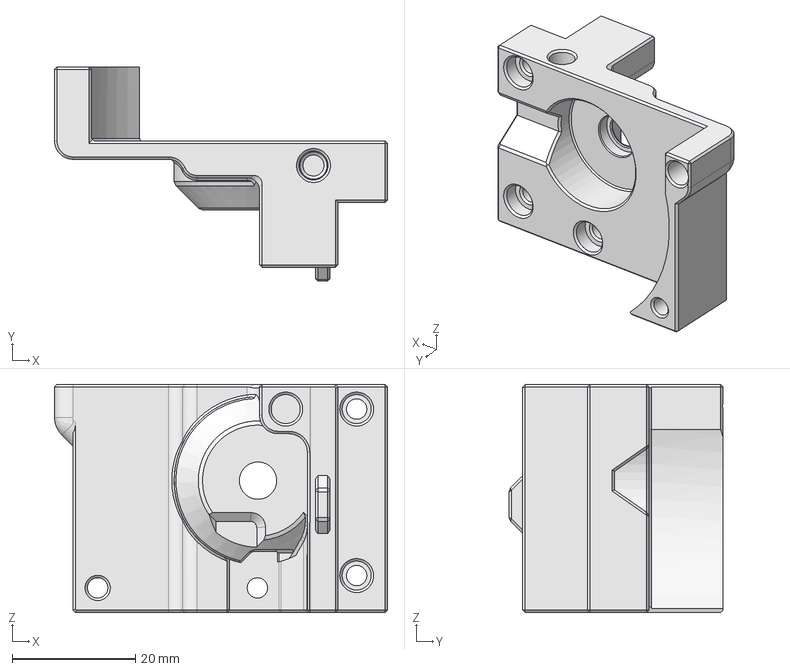
[picture p100: CAD file, 2024-07-21]
ercf_v2/cnc_80T_pulley_mod/Gear_Box_Back_CNC_80T.step
54.0 x 34.8 x 37.0 mm
