ntchris/voron_mod_super_diy/ercf_v2/EREC_Cutter_Beta7_Mod/CAD/Servo_Base.step

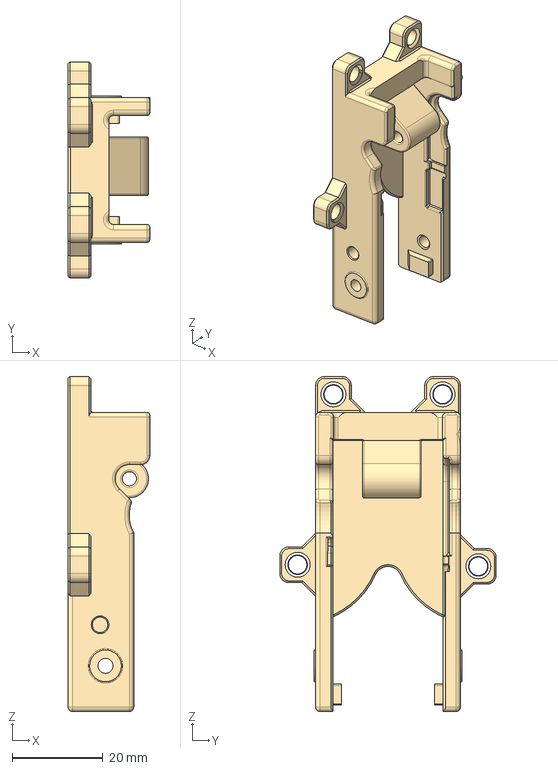
[picture p101: CAD file, 2024-09-14]
ercf_v2/EREC_Cutter_Beta7_Mod/CAD/Servo_Base.step
18.0 x 47.8 x 74.0 mm
