ntchris/voron_mod_super_diy/ercf_v2/etc/ercf_v2_middle_foot.step

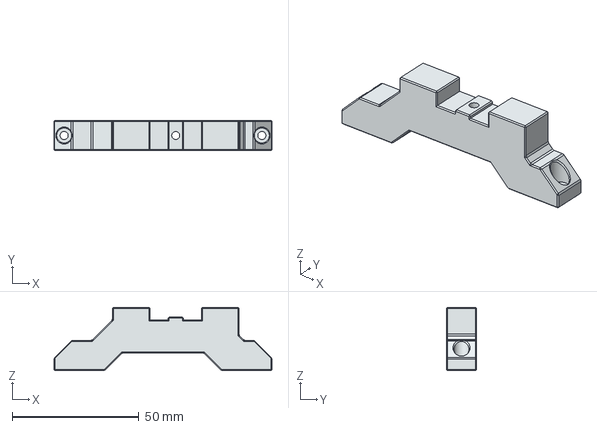
[picture p102: CAD file, 2024-08-10]
ercf_v2/etc/ercf_v2_middle_foot.step
86.0 x 12.0 x 25.0 mm
