ntchris/voron_mod_super_diy/ercf_v2/filament_tension_sensor_hall/CAD/bottom.step

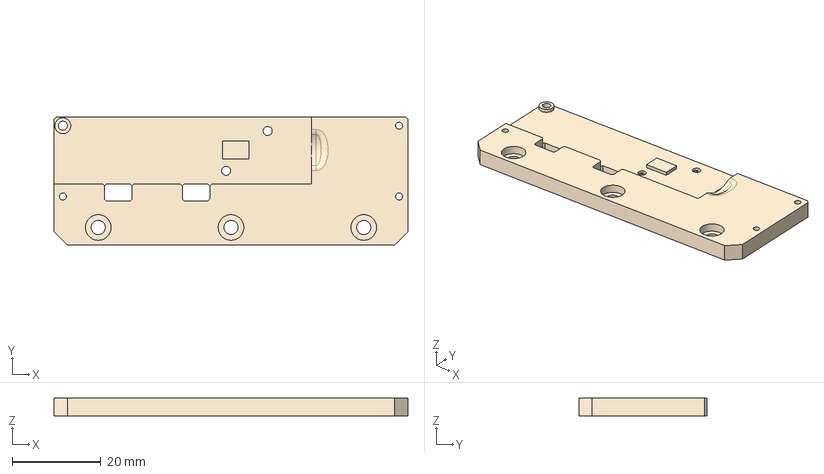
[picture p103: CAD file, 2024-08-27]
ercf_v2/filament_tension_sensor_hall/CAD/bottom.step
80.0 x 29.0 x 4.00 mm
