ntchris/voron_mod_super_diy/ercf_v2/power_drive_selector_60T_pulley/CAD/ERCF_V2_EndBlock_Bypass_M4.step

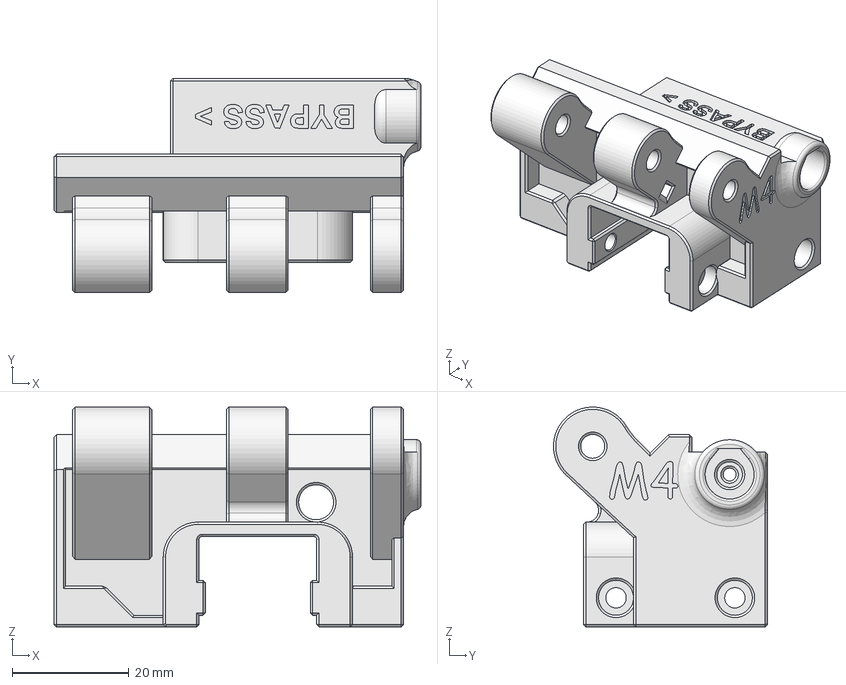
[picture p104: CAD file, 2024-08-10]
ercf_v2/power_drive_selector_60T_pulley/CAD/ERCF_V2_EndBlock_Bypass_M4.step
63.0 x 36.7 x 37.7 mm
