ntchris/voron_mod_super_diy/ercf_v2/servo_28mm_selector_ver2/CAD/Linear Axis Idler Block M4.step

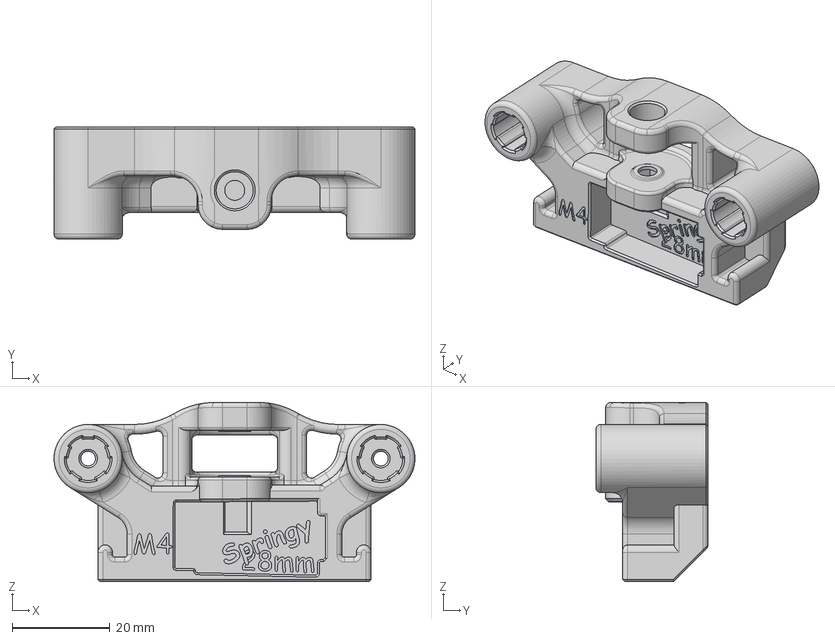
[picture p105: CAD file, 2024-09-14]
ercf_v2/servo_28mm_selector_ver2/CAD/Linear Axis Idler Block M4.step
74.0 x 23.0 x 36.7 mm
