ntchris/voron_mod_super_diy/for_enraged_rabbit/easy_optical/cad_stl/Encoder_Left.step

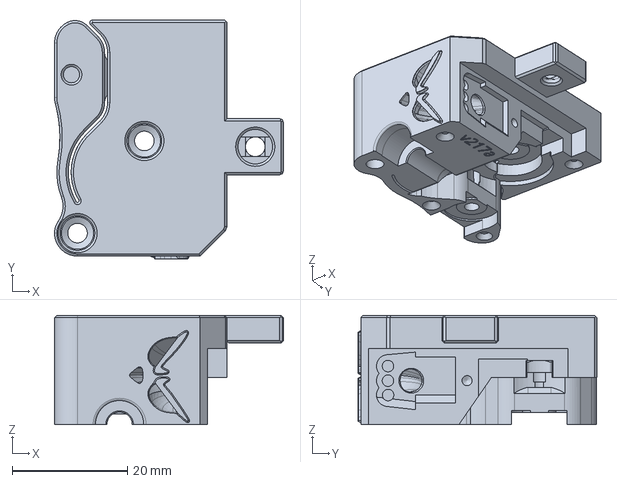
[picture p106: CAD file, 2023-10-31]
for_enraged_rabbit/easy_optical/cad_stl/Encoder_Left.step
39.8 x 41.5 x 19.0 mm
