ntchris/voron_mod_super_diy/for_enraged_rabbit/optical_endstop_selector/optical_endstop_mount.stl

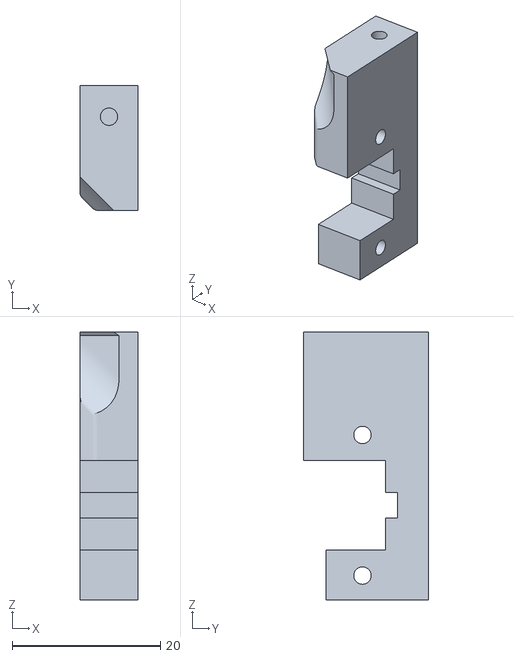
[picture p108: CAD file, 2023-10-22]
for_enraged_rabbit/optical_endstop_selector/optical_endstop_mount.stl
7.86 x 16.8 x 36.2
