ntchris/voron_mod_super_diy/for_enraged_rabbit/optical_endstop_selector_button/optical_mount.stl

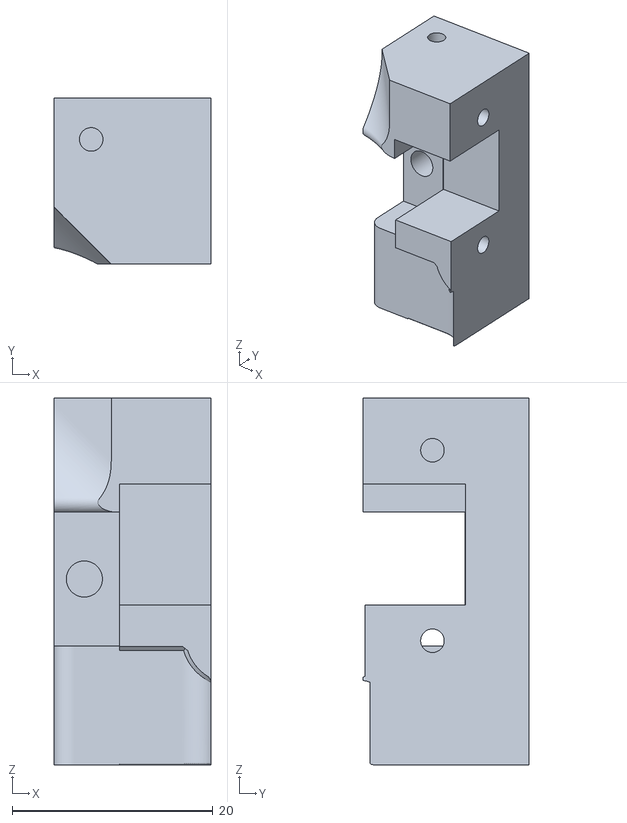
[picture p109: CAD file, 2023-10-22]
for_enraged_rabbit/optical_endstop_selector_button/optical_mount.stl
15.6 x 16.6 x 36.6
