ntchris/voron_mod_super_diy/stealth_burner_rail_mount/x_carriage_frame_left_and_right_belt_wrap.stl

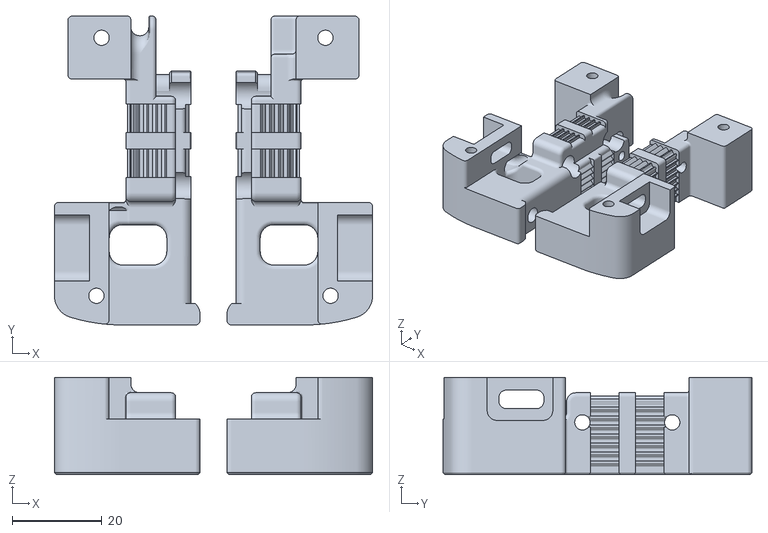
[picture p110: CAD file, 2023-09-17]
stealth_burner_rail_mount/x_carriage_frame_left_and_right_belt_wrap.stl
70.8 x 68.8 x 21.6
