ntchris/voron_mod_super_diy/ercf_v2/power_drive_selector_60T_pulley/CAD/selector_motor_mount_nema14.step

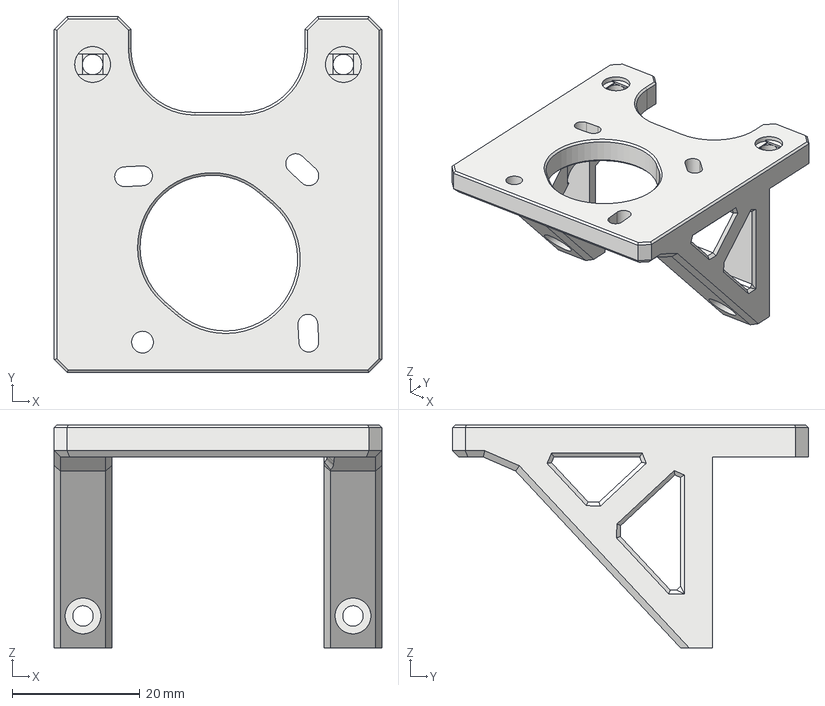
[picture p112: CAD file, 2024-08-10]
ercf_v2/power_drive_selector_60T_pulley/CAD/selector_motor_mount_nema14.step
51.2 x 55.7 x 34.8 mm
