ntchris/voron_mod_super_diy/ercf_v2/servo_28mm_selector_ver2/CAD/[a]Selector_for_servo28mm.step

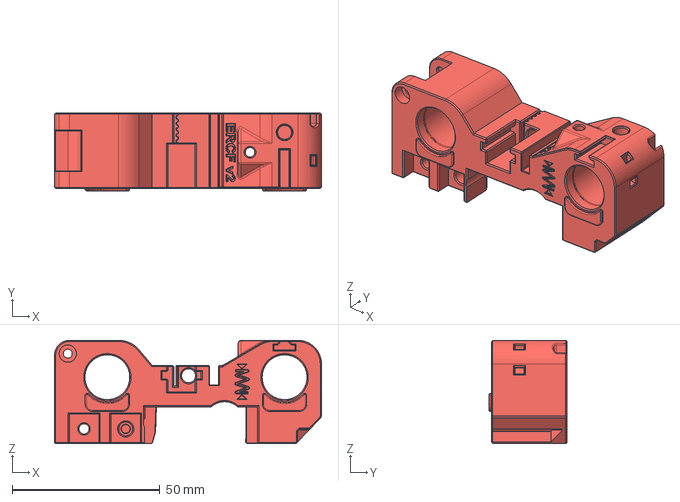
[picture p113: CAD file, 2024-09-14]
ercf_v2/servo_28mm_selector_ver2/CAD/[a]Selector_for_servo28mm.step
90.4 x 26.3 x 35.0 mm
