ntchris/voron_mod_super_diy/for_enraged_rabbit/easy_optical/cad_stl/Encoder_Right.step

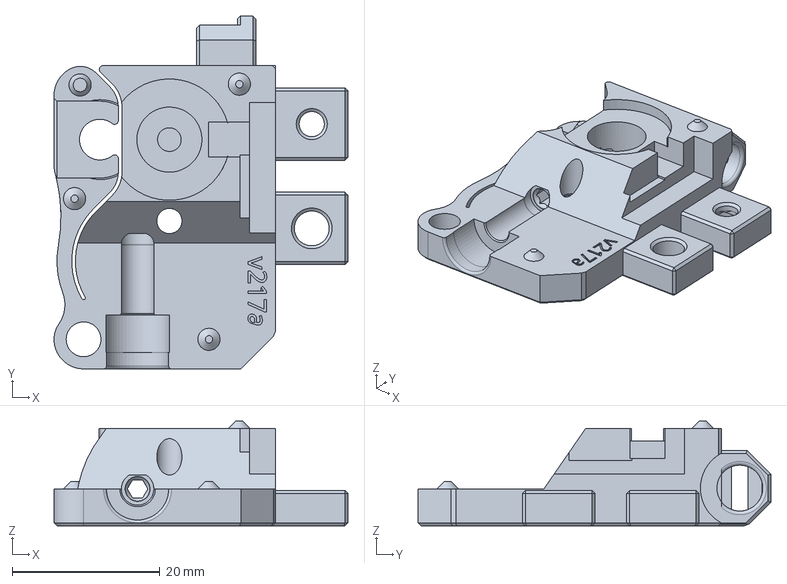
[picture p114: CAD file, 2023-10-31]
for_enraged_rabbit/easy_optical/cad_stl/Encoder_Right.step
39.8 x 47.7 x 14.2 mm
