ntchris/voron_mod_super_diy/for_enraged_rabbit/mount_on_voron/ercf_mount_left.step

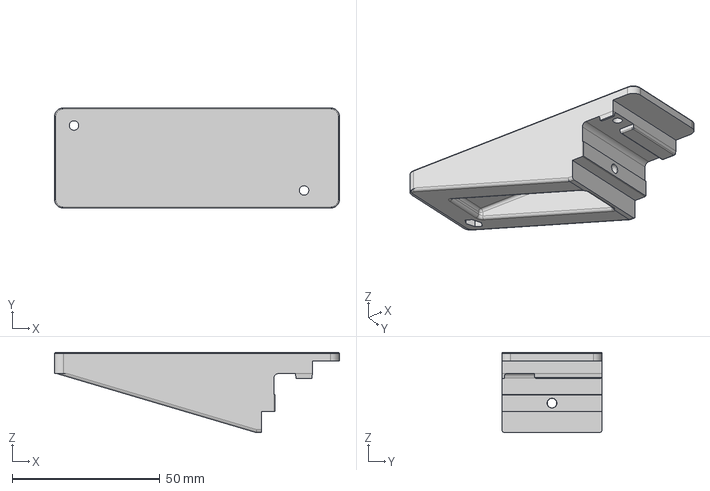
[picture p115: CAD file, 2023-09-17]
for_enraged_rabbit/mount_on_voron/ercf_mount_left.step
96.6 x 34.0 x 27.2 mm
