ntchris/voron_mod_super_diy/for_enraged_rabbit/optical_endstop_selector_button/pin_button_back.stl

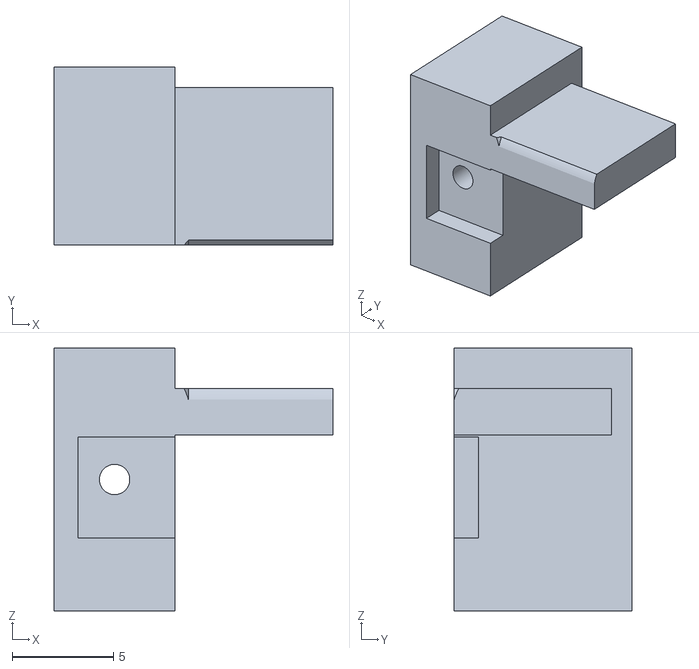
[picture p116: CAD file, 2023-10-22]
for_enraged_rabbit/optical_endstop_selector_button/pin_button_back.stl
13.8 x 8.80 x 13.0
