ntchris/voron_mod_super_diy/XY_Joints/xy_joint_right_lower_M4.step

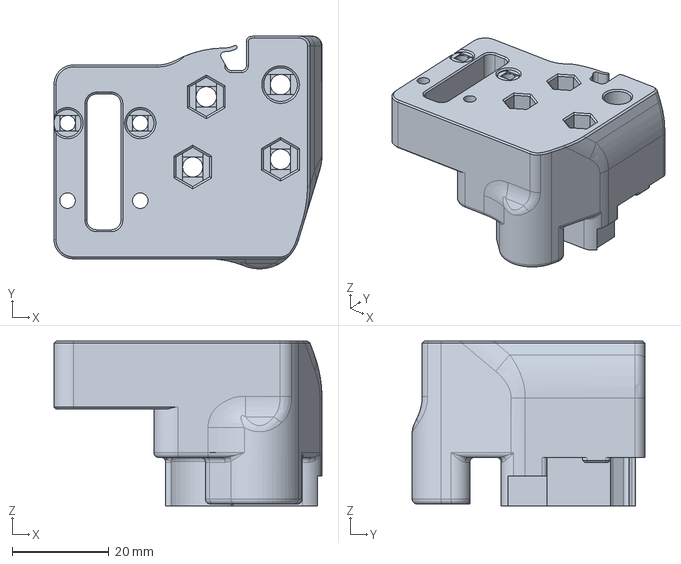
[picture p117: CAD file, 2023-09-17]
XY_Joints/xy_joint_right_lower_M4.step
55.3 x 48.0 x 34.0 mm
