ntchris/voron_mod_super_diy/ercf_v2/EREC_Cutter_Beta7_Mod/CAD/Servo_Gear.step

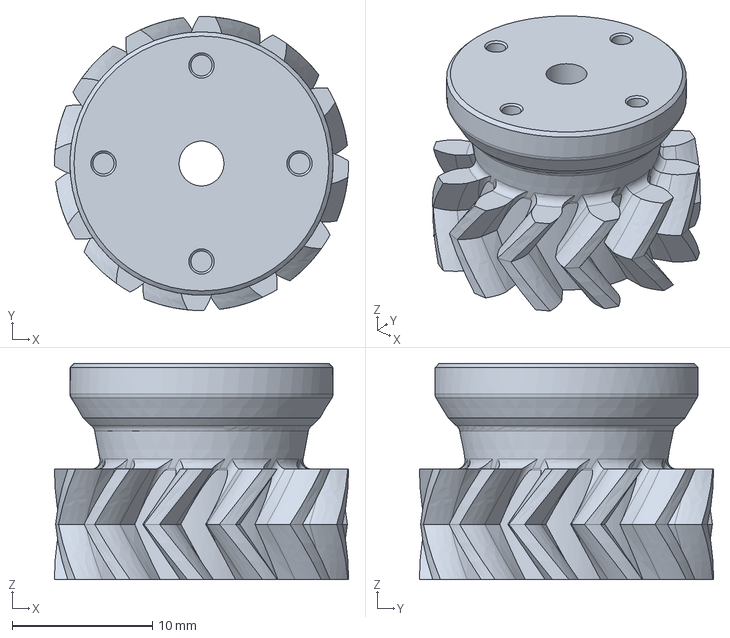
[picture p118: CAD file, 2024-09-14]
ercf_v2/EREC_Cutter_Beta7_Mod/CAD/Servo_Gear.step
21.0 x 21.0 x 15.4 mm
