ntchris/voron_mod_super_diy/ercf_v2/servo_28mm_selector_ver2/CAD/servo_arm_6mm_25T_servo_shaft v31.step

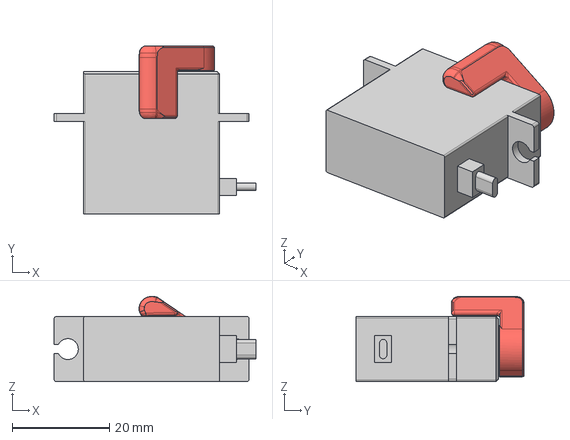
[picture p119: CAD file, 2024-09-14]
ercf_v2/servo_28mm_selector_ver2/CAD/servo_arm_6mm_25T_servo_shaft v31.step
41.6 x 34.7 x 17.5 mm
prd00355951
servo_arm_6mm_25T
