ntchris/voron_mod_super_diy/for_enraged_rabbit/mount_on_voron/ercf_pcb_mount_side.step

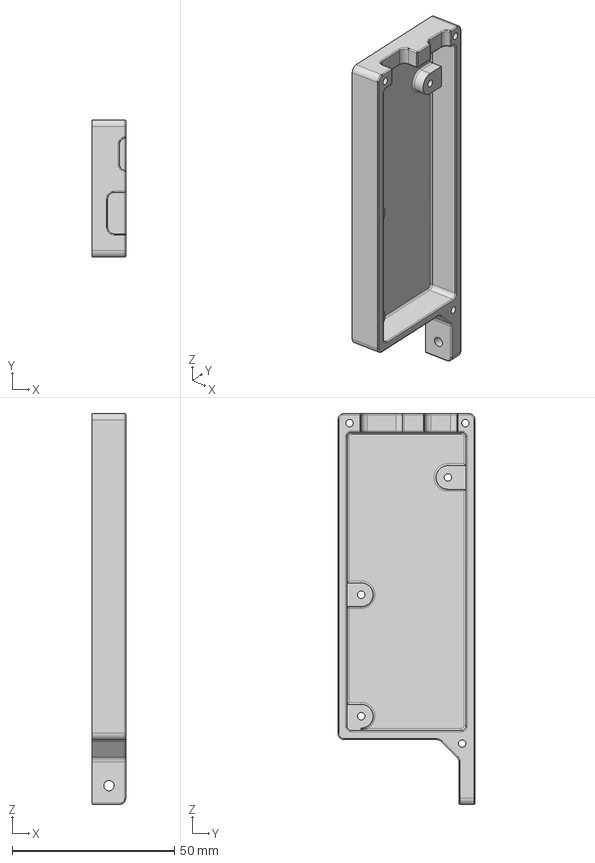
[picture p120: CAD file, 2023-09-17]
for_enraged_rabbit/mount_on_voron/ercf_pcb_mount_side.step
10.4 x 42.4 x 120.7 mm
