ntchris/voron_mod_super_diy/ercf_v2/servo_28mm_selector_ver2/CAD/servo_28mm_holder.step

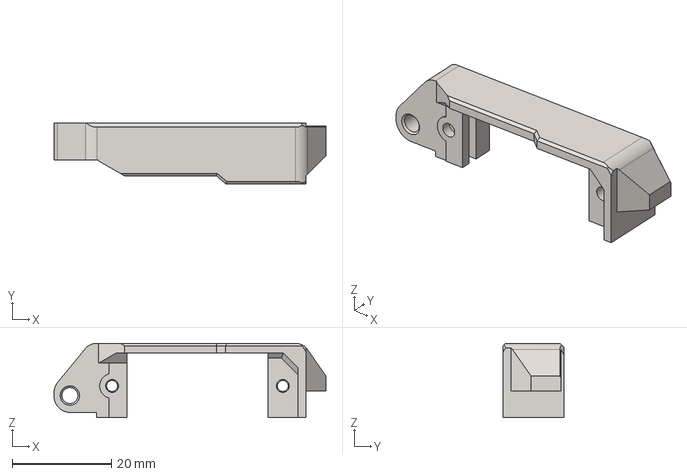
[picture p121: CAD file, 2024-09-14]
ercf_v2/servo_28mm_selector_ver2/CAD/servo_28mm_holder.step
54.8 x 12.2 x 15.0 mm
