ntchris/voron_mod_super_diy/(list of files, cad)

Other CAD files:
ercf_v2/power_drive_selector_60T_pulley/CAD/M4_pulley_mount.step
Z_Idlers_mods/z_tensioner_bracket_M4_a_x2.step
ercf_v2/EREC_Cutter_Beta7_Mod/CAD/EREC_Cutter_Encoder_Right_servo_28mm_Vbearing.step
ercf_v2/power_drive_selector_60T_pulley/CAD/pulley_mount_M4.step
ercf_v2/servo_28mm_selector_ver2/CAD/Linear Axis Idler Block Default M5.step
Exhaust_Filter/Voron2.4_Exhaust Mount_M3 v3.f3d
Exhaust_Filter/[a]_exhaust_filter_mount_M3_x2.stl
XY_Joints/xy_joint_left_lower_M4.f3d
XY_Joints/xy_joint_left_lower_M4.stl
XY_Joints/xy_joint_left_upper_M4.f3d
XY_Joints/xy_joint_left_upper_M4.stl
XY_Joints/xy_joint_right_lower_M4.f3d
XY_Joints/xy_joint_right_lower_M4.stl
XY_Joints/xy_joint_right_upper_M4.f3d
XY_Joints/xy_joint_right_upper_M4.stl
Z_Idlers_mods/Z Idler A_B_M4 v7.f3d
Z_Idlers_mods/z_tensioner_bracket_M4_a_x2.stl
Z_Idlers_mods/z_tensioner_bracket_M4_b_x2.stl
ercf_v2/EREC_Cutter_Beta7_Mod/stl/Cutter_Arm ECAS_Open.stl
ercf_v2/EREC_Cutter_Beta7_Mod/stl/EREC_Cutter_Encoder_Right_servo_28mm_Vbearing.stl
ercf_v2/EREC_Cutter_Beta7_Mod/stl/Servo_Base.stl
ercf_v2/EREC_Cutter_Beta7_Mod/stl/ercf_cutter_beta7_adaptor.stl
ercf_v2/cnc_80T_pulley_mod/Gear_Box_Back_CNC_80T.f3d
ercf_v2/cnc_80T_pulley_mod/Gear_Box_Back_CNC_80T.stl
ercf_v2/cnc_80T_pulley_mod/washer_5.4mm.step
ercf_v2/cnc_80T_pulley_mod/washer_5.4mm.stl
ercf_v2/cnc_80T_pulley_mod/washer_5.6mm.stl
ercf_v2/cnc_80T_pulley_mod/washer_5.8mm.stl
ercf_v2/etc/ercf_v2_middle_foot.stl
ercf_v2/filament_tension_sensor_hall/stl/bottom.stl
ercf_v2/filament_tension_sensor_hall/stl/case.stl
ercf_v2/filament_tension_sensor_hall/stl/mover.stl
ercf_v2/filament_tension_sensor_hall/super_filament_tension_detector_smaller v23.f3z
ercf_v2/power_drive_selector_60T_pulley/stl/ERCF_V2_EndBlock_Bypass_M4.stl
ercf_v2/power_drive_selector_60T_pulley/stl/selector_motor_mount_nema14.stl
ercf_v2/servo_28mm_selector/CAD/LinearAxisIdlerBlock.step
ercf_v2/servo_28mm_selector/CAD/LinearAxisIdler_Block_M4.step
ercf_v2/servo_28mm_selector/CAD/[a]Selector_for_servo28mm.step
ercf_v2/servo_28mm_selector/CAD/drag_Chain_Anchor_28mm_servo.step
ercf_v2/servo_28mm_selector/CAD/erec_beta6_encoder_mount_for_thicker_selector_28mm.step
ercf_v2/servo_28mm_selector/CAD/servo_28mm_holder.step
ercf_v2/servo_28mm_selector/CAD/servo_arm_6mm_25T.step
ercf_v2/servo_28mm_selector/stl/LinearAxisIdlerBlock.stl
ercf_v2/servo_28mm_selector/stl/LinearAxisIdler_Block_M4.stl
ercf_v2/servo_28mm_selector/stl/[a]Selector_for_servo28mm.stl
ercf_v2/servo_28mm_selector/stl/drag_Chain_Anchor_28mm_servo.stl
ercf_v2/servo_28mm_selector/stl/erec_beat6_encoder_mount_for_thicker_selector_28mm.stl
ercf_v2/servo_28mm_selector/stl/servo_28mm_holder.stl
ercf_v2/servo_28mm_selector/stl/servo_arm_6mm_25T.stl
ercf_v2/servo_28mm_selector/stl/servo_hole_filler.stl
ercf_v2/servo_28mm_selector_ver2/stl/Linear Axis Idler Block Default M5.stl
ercf_v2/servo_28mm_selector_ver2/stl/Linear Axis Idler Block M4.stl
ercf_v2/servo_28mm_selector_ver2/stl/[a]Selector_for_servo28mm.stl
ercf_v2/servo_28mm_selector_ver2/stl/servo_28mm_holder.stl
ercf_v2/servo_28mm_selector_ver2/stl/servo_arm_6mm_25T.stl
for_enraged_rabbit/easy_optical/cad_stl/Encoder_Left.stl
for_enraged_rabbit/easy_optical/cad_stl/Encoder_Right.stl
for_enraged_rabbit/easy_optical/cad_stl/Encoder_Slotted_Wheel.stl
for_enraged_rabbit/mount_on_voron/ercf_mount_left.stl
for_enraged_rabbit/mount_on_voron/ercf_mount_mid.stl
for_enraged_rabbit/mount_on_voron/ercf_pcb_mount_side.stl
for_enraged_rabbit/mount_on_voron/ercft_mount_right.stl
stealth_burner_rail_mount/x_carriage_frame_left_belt_wrap.stl
stealth_burner_rail_mount/x_carriage_frame_right_belt_wrap.stl
