ntchris/voron_mod_super_diy/for_enraged_rabbit/optical_endstop_selector/install.jpg

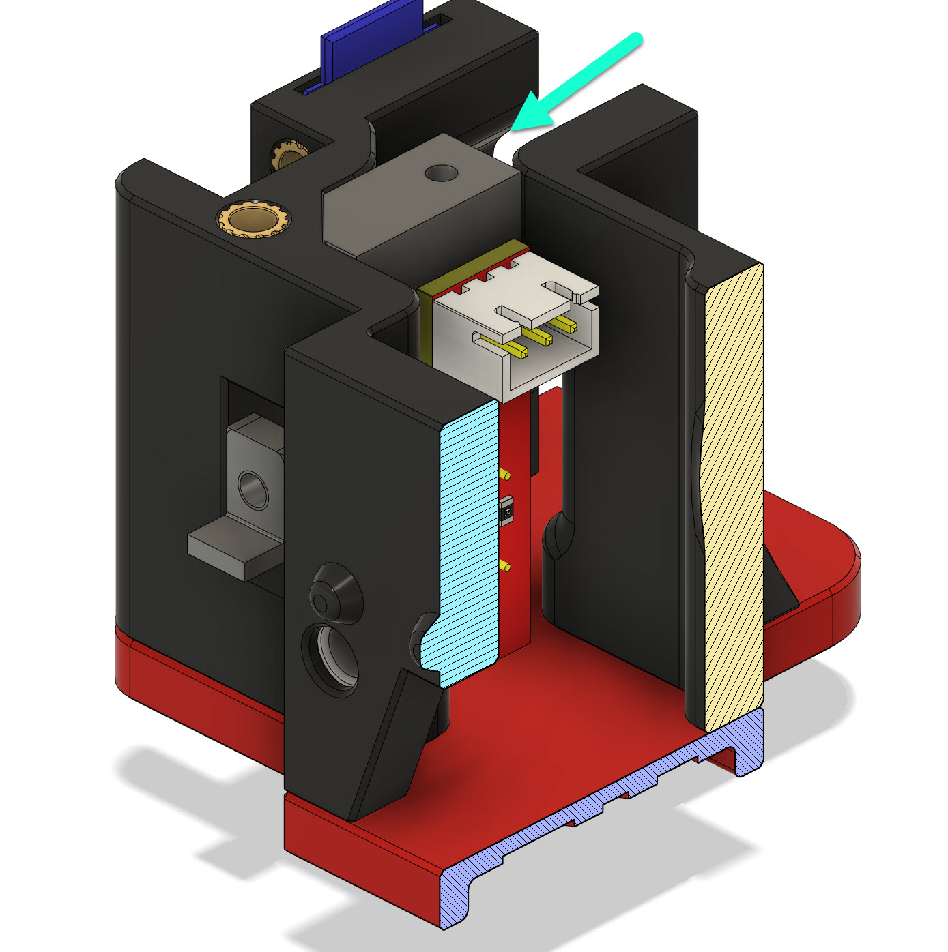
for_enraged_rabbit/optical_endstop_selector/install.jpg
