ntchris/voron_mod_super_diy/super_diy_motor_buffer_mmu_samla/doc/motor_base_install.jpg

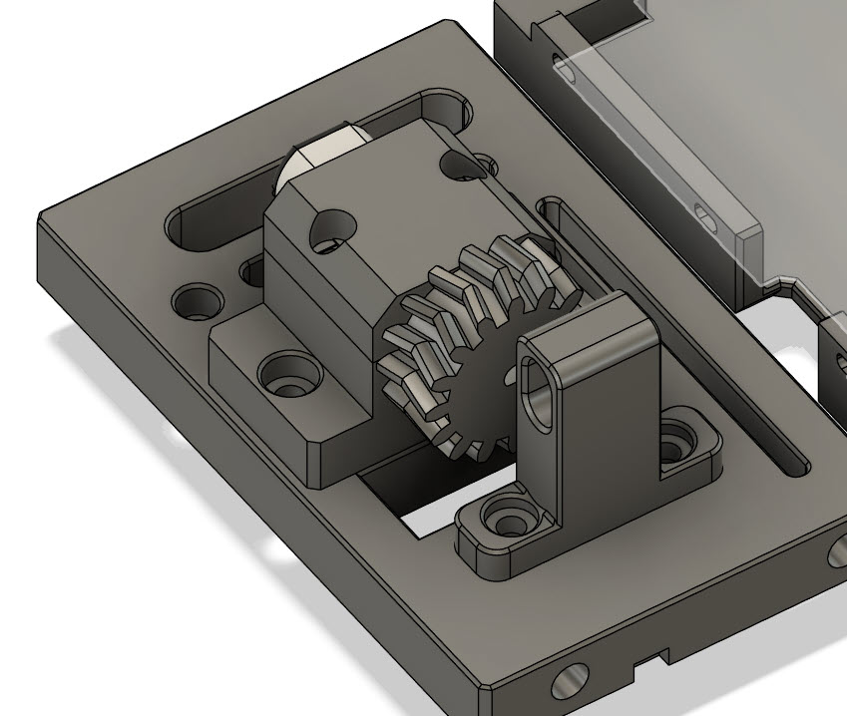
super_diy_motor_buffer_mmu_samla/doc/motor_base_install.jpg
