ntchris/voron_mod_super_diy/ercf_v2/power_drive_selector_60T_pulley/pictures/belt_length_measure.png

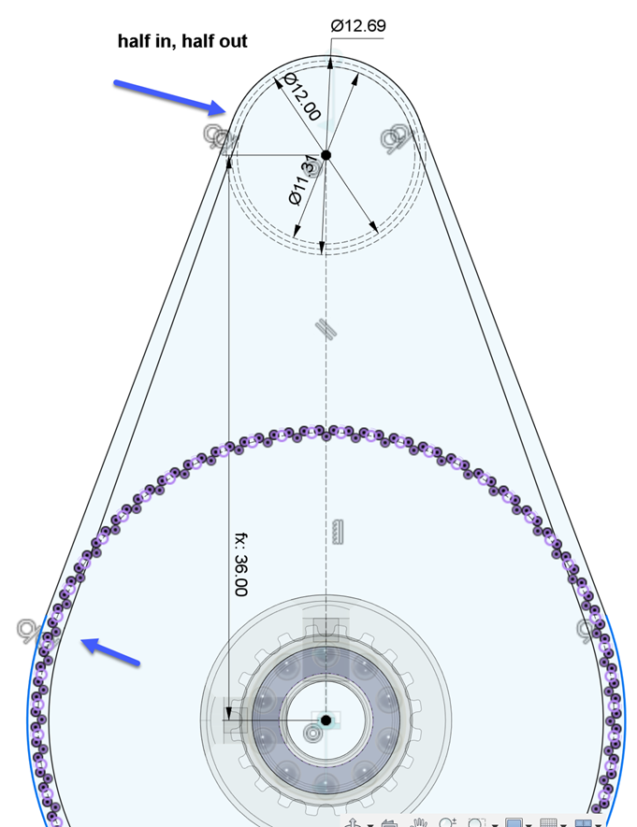
ercf_v2/power_drive_selector_60T_pulley/pictures/belt_length_measure.png
