ntchris/voron_mod_super_diy/for_enraged_rabbit/easy_optical/easy_optical_pcb/easy_optical_pcb.kicad_pcb

## KiCad design for_enraged_rabbit/easy_optical/easy_optical_pcb/easy_optical_pcb.kicad_pcb (2024-09-14)

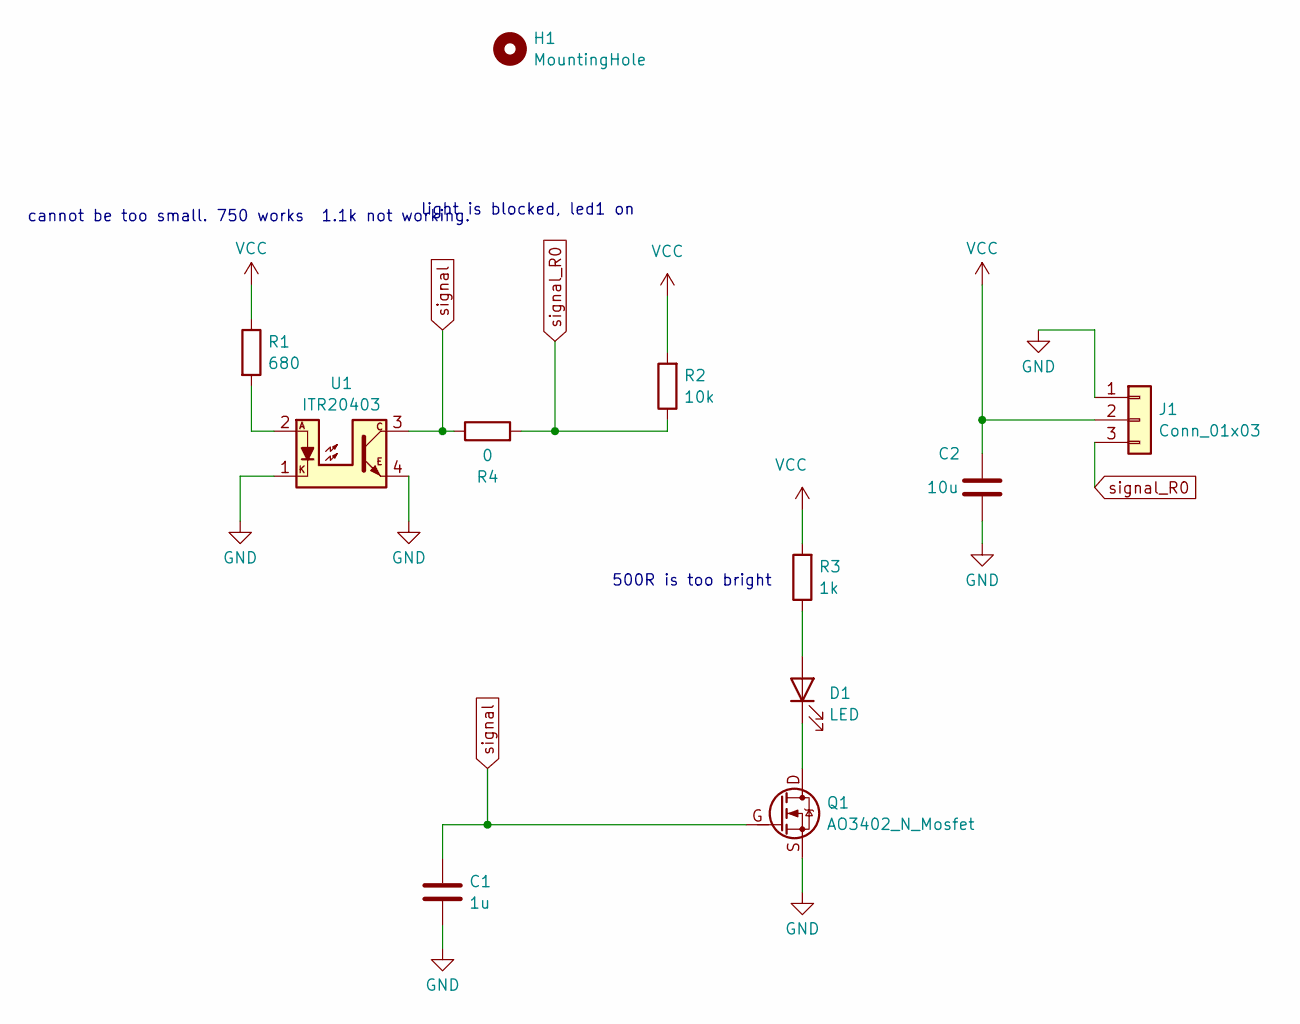
[picture p128: schematic easy_optical_pcb.kicad_sch]

Parts:
C1: 1u; C_0805_2012Metric_Pad1.20x1.50mm_HandSolder
C2: 10u; C_0805_2012Metric_Pad1.20x1.50mm_HandSolder
D1: LED; LED_D3.0mm
H1: MountingHole; MountingHole_2.1mm
J1: Conn_01x03; PinHeader_1x03_P2.54mm_Vertical
Q1: AO3402_N_Mosfet; SOT-23_PMOSFET
R1: 680; R_0805_2012Metric_Pad1.20x1.50mm_HandSolder
R2: 10k; R_0805_2012Metric_Pad1.20x1.50mm_HandSolder
R3: 1k; R_0805_2012Metric_Pad1.20x1.50mm_HandSolder
R4: 0; R_1206_3216Metric_Pad1.33x1.80mm_HandSolder
U1: ITR20403; Optical_ITR20403

Connections:
GND: C1.2, C2.2, J1.1, Q1.S, U1.1, U1.4
unnamed: D1.A, R3.1
unnamed: D1.K, Q1.D
unnamed: R1.2, U1.2
VCC: C2.1, J1.2, R1.1, R2.2, R3.2
signal: C1.1, Q1.G, R4.1, U1.3
signal_R0: J1.3, R2.1, R4.2

Notes on the sheet:
cannot be too small. 750 works 1.1k not working.
light is blocked, led1 on
500R is too bright

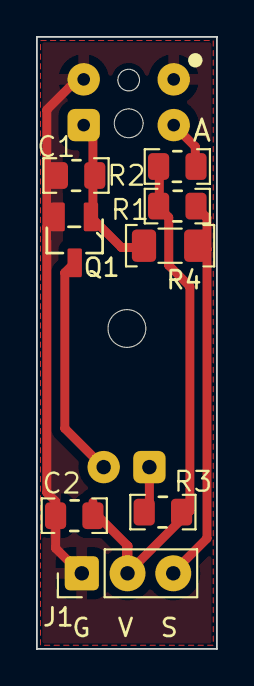
[picture p129: board easy_optical_pcb.kicad_pcb from above]

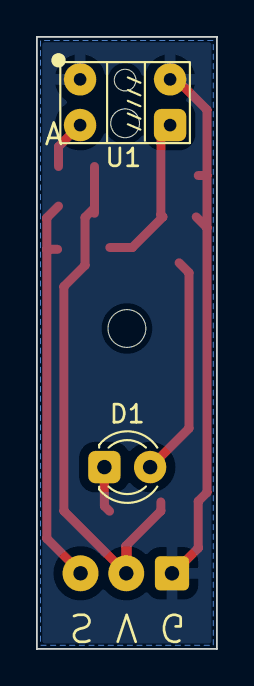
[picture p130: board easy_optical_pcb.kicad_pcb from below]

Board: 2 copper layers, 10.0 x 34.0 mm, 11 parts (2 on the bottom side), 7 nets.
