ntchris/voron_mod_super_diy/(commit log)

2023-09-17 continue to init
    continue to init
    [Stealthburner_CW2_Main_Body_ERCF.stl]
2023-09-17 add ercf klipper config
2023-09-17 add uart jumper picture
    add uart jumper picture
2023-09-17 added readme
    [ercf_hardware_mellow_canbus.cfg]
2023-09-17 added a few more config file for ERCF
    [ercf_hardware_mellow_canbus.cfg, ercf_parameters.cfg, ercf_software.cfg]
2023-09-19 more notes and pin diagram
2023-10-22 added BTT ERCF
    [btt_ercf_canbus_pin.cfg, btt_mmb_ercf_canbus.cfg, ercf_hardware_mellow_canbus.cfg, ercf_pcb_mount_side_mellow_canbus.stl, ercf_top_panel_optical.stl, light_blocker_M3.stl, optical_endstop_mount.stl, optical_mount.stl]
2023-10-22 fix motor pin photo
    fix motor pin photo
2023-10-22 remove btt template config file
    [btt_ercf_canbus_pin.cfg]
2023-10-31 adding ERCF easy optical project
    [Encoder_Left.step, Encoder_Left.stl, Encoder_Right.step, Encoder_Right.stl, Encoder_Slotted_Wheel.step, Encoder_Slotted_Wheel.stl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]
2023-10-31 modify readme
    shrink pictures
    [easy_optical_pcb.kicad_sch]
2023-10-31 move pcb step file to the CAD folder
    [easy_optical_pcb.step]
2024-07-20 add more projects
    [Gear_Box_Back_CNC_80T.step, Gear_Box_Back_CNC_80T.stl, easy_optical_pcb.csv, easy_optical_pcb.kicad_pcb, easy_optical_pcb.kicad_sch, ercf_hardware_mellow_canbus.cfg, washer_5.4mm.step, washer_5.4mm.stl]
2024-07-21 add gear box black mod for 80T cnc metal pulley
    [Gear_Box_Back_CNC_80T.f3d, Gear_Box_Back_CNC_80T.step, Gear_Box_Back_CNC_80T.stl]
2024-08-10 add ercf v2 selector power drive pulley 60T and 20T driving system
    add ercf v2 selector power drive pulley 60T and 20T driving system
    [ERCF_V2_EndBlock_Bypass_M4.step, ERCF_V2_EndBlock_Bypass_M4.stl, ercf_v2_middle_foot.step, ercf_v2_middle_foot.stl, pulley_mount_M4.step, pulley_mount_default_M5.step, selector_motor_mount_nema14.step, selector_motor_mount_nema14.stl]
2024-08-10 rename folder to power drive selector 60T pulley
    rename folder to power drive selector 60T pulley
    [ERCF_V2_EndBlock_Bypass_M4.step, ERCF_V2_EndBlock_Bypass_M4.stl, pulley_mount_M4.step, pulley_mount_default_M5.step, selector_motor_mount_nema14.step, selector_motor_mount_nema14.stl]
2024-08-10 add more picture
    [ERCF_V2_EndBlock_Bypass_M4.stl, selector_motor_mount_nema14.stl]
2024-08-10 add front view pictures and screw pictures
2024-08-10 added stepper motor screw warning
2024-08-10 remove finger from picture
2024-08-11 rotate stl file to the correct print orientation
    [ercf_v2_middle_foot.stl, selector_motor_mount_nema14.stl]
2024-08-11 to let ERCF V2 support larger 28mm servo
    to let ERCF V2 support larger 28mm servo
    [LinearAxisIdlerBlock.step, LinearAxisIdlerBlock.stl, LinearAxisIdler_Block_M4.step, LinearAxisIdler_Block_M4.stl, [a]Selector_for_servo28mm.step, [a]Selector_for_servo28mm.stl, drag_Chain_Anchor_28mm_servo.step, drag_Chain_Anchor_28mm_servo.stl]
2024-08-27 add filament tension sensor module
    [bottom.step, bottom.stl, case.step, case.stl, drag_chain_body.stl, kicad_two_way_hall.kicad_pcb, kicad_two_way_hall.kicad_sch, mover.step]
2024-09-14 add 28mm servo selector Version2
    [EREC_Cutter_Encoder_Right_servo_28mm_Vbearing.step, EREC_Cutter_Encoder_Right_servo_28mm_Vbearing.stl, Linear Axis Idler Block Default M5.step, Linear Axis Idler Block Default M5.stl, Linear Axis Idler Block M4.step, Linear Axis Idler Block M4.stl, M4_pulley_mount.step, [a]Selector_for_servo28mm.step]
2024-09-14 update power selector drive f3z file
2024-09-14 update servo arm stl orientation for print
    [servo_arm_6mm_25T.stl]
2024-09-14 add ercf cutter beta7 mod
    [Cutter_Arm ECAS_Open.stl, Cutter_Arm_ECAS_Open.step, EREC_Cutter_Encoder_Right_servo_28mm_Vbearing.step, EREC_Cutter_Encoder_Right_servo_28mm_Vbearing.stl, Servo_Base.step, Servo_Base.stl, Servo_Gear.step, ercf_cutter_beta7_adaptor.step]
2024-09-14 ercf cutter add cad file and change description
2024-09-14 update stl orientation
    [Cutter_Arm ECAS_Open.stl, Servo_Base.stl, ercf_cutter_beta7_adaptor.stl]
2025-02-14 add motor buffer samla project source code and doc
