ntchris/voron_mod_super_diy/XY_Joints/M4_xy_joint_left.jpg

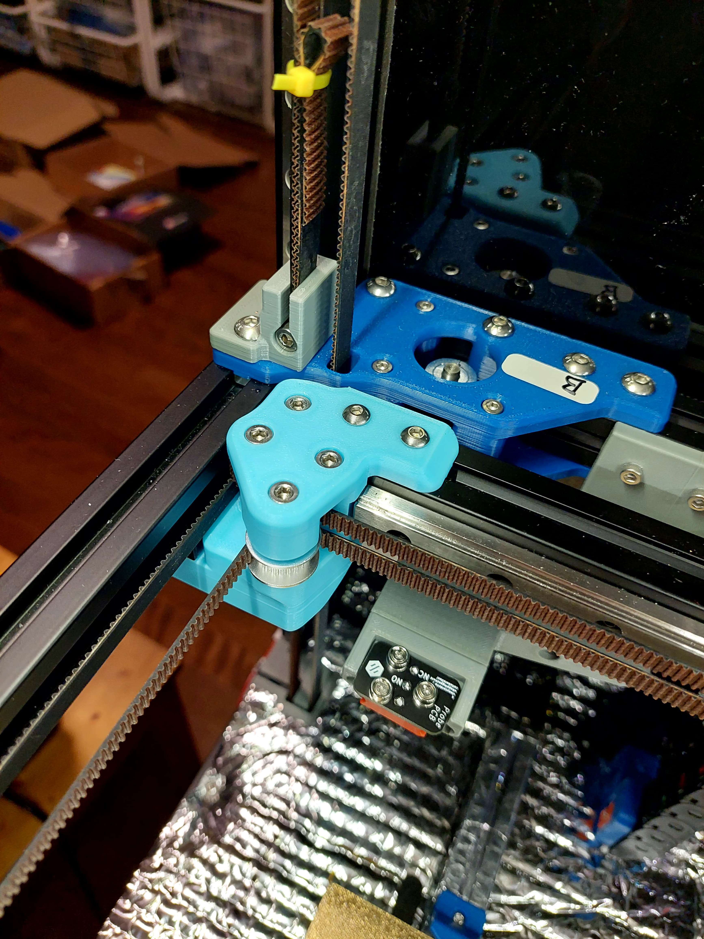
XY_Joints/M4_xy_joint_left.jpg
