ntchris/voron_mod_super_diy/XY_Joints/M4_xy_joint_right.jpg

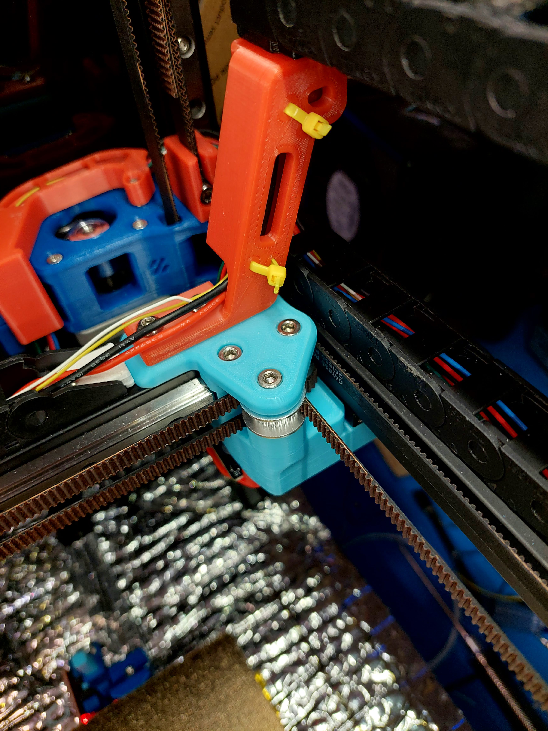
XY_Joints/M4_xy_joint_right.jpg
